FormicoRofo/1438-Puit-de-courant/3-Documents/1438-3501-00-Rapport_RD_pendant_le_TPI.docx

# Puit de courant

Table des matières

Versions

Version | Date | Auteur | Remarques
00 | 2024-04-24 | Alyx Vasseur | Version initiale

# 1 Cahier des charges

L’objectif de ce travail de TPI est de réaliser une carte de puit de courant réglable. Le design est tiré d’un article paru dans le magazine Elektor numéro 503 à la page 42. Pour plus de détail, consulter le cahier des charges numéro 1438.3001.00.

# 2 Planification

Liste des tâches | Durée
Routage et commande de PCB | 15H40
Fabrication et mise en service | 13H20
Documentation et administratif | 17H00
Total | 46H00

Planification complète : voir Planification numéro 1438.3600.00.

# 3 Analyse

## 3.1 Analyse de l'existant

Lors du pré-TPI, j’ai déjà analysé la réalisation de l’article d’Elektor et réalisé un schéma adapté dans Altium, et commandé les composants adaptés. Le détail de ce travail se trouve dans le document numéro 1438.3500.00.

## 3.2 Prise de décisions

J’ai choisi de partir sur une conception de PCB sur deux faces, avec des composants THT et SMD sur la face avant uniquement. Ainsi, la fabrication et le dépannage sont simplifiés et le stockage dans des racks est potentiellement plus simple. J’ai décidé d’organiser le PCB de la manière qui me semblait le plus ergonomique possible : Les connexions à l’alimentation et le fusible sur la gauche, et les réglages et points de connexion pour les instruments de mesure sur la droite. J’ai décidé de mettre des points de mesure à anneaux sur tous les points où une mesure au voltmètre serait envisageable, et des picots jumpers à tous les endroits où une mesure à l’oscilloscope pourrait être réalisée. J’ai également fait attention à ne placer aucun trimmer ou jumper immédiatement derrière un dissipateur thermique, ce qui rendrait moins pratique l’utilisation.

C’est une configuration qui favorise évidemment les utilisateurs droitiers, car il est plus compliqué de manipuler le bord droit de la carte de la main gauche. Cependant, une fois l’alimentation connectée, tourner la carte de 90° dans le sens horaire permet un accès totalement ambidextre aux réglages et points de mesure.

## 3.3 Problèmes rencontrés

### 3.3.1 Augmentation du courant à basse tension

Lors de la mise en service, j’ai remarqué que quand la tension d’alimentation est entre 3,1 et 3,6V, la linéarité du courant tiré n’est pas maintenue. Contre intuitivement ce denier augmente dans cette plage. Ceci se produit car la tension normalement régulée de -1,25V servant à commander le LM317 commence à se rapprocher de zéro. Cela a pour effet d’augmenter la tension de sortie du LM317, et donc l’appel de courant de tout le circuit. Pour résoudre ce problème, j’envisagerais deux solutions : remplacer le LM317 par un autre régulateur capable de sortir une tension de 0V sans autre circuit autour, ce qui permettrait de se passer complétement du bloc pompe de charge, ou remplacer le transistor K8 par un transistor au germanium et adapter les diodes R41 et R46. Ainsi la tension au point X17 sera plus haute de 0.4V lorsque l’alimentation sera dans le régime problématique grâce à sa tension UBE réduite. Cette mesure devrait à minima repousser la zone problématique à moins de 3,3V. Même si le problème persisterait probablement dans une moindre mesure entre 3,1 et 3,2V environ, le problème ne se situerait plus dans la zone opérationnelle de la carte.

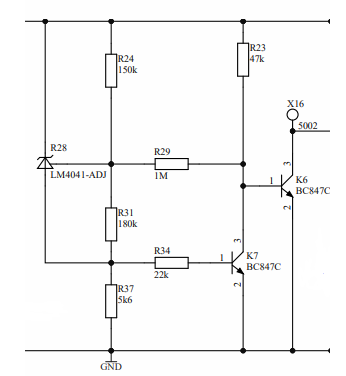
[picture p1: figure]

Après en avoir parlé à mon responsable de TPI, ses instructions sont de trouver un moyen d’augmenter la tension à partir de laquelle la protection contre les sous-tensions se déclenche. Ceci peut se faire sans trop de problème en changeant la résistance R24 par une valeur plus petite. Pour calculer cette valeur, il faut d’abord comprendre comment fonctionne cet arrêt.

Le régulateur shunt R28 laisse passer du courant de manière à toujours avoir 1,24V entre sa patte d’ajustement et sa patte positive. Ainsi, on peut facilement calculer le courant qui passe dans R24 (1,24/150000=8,266µA). Considérant R29 comme étant négligeable par rapport à R31 ou R24 on peut établir que la chute de tension sur R31 vaudra (180 * 8,266 *10⁻³ =1,488V). On peut donc déterminer que la chute de tension aux bornes de R28 sera de 2,72 V. Lorsque la tension d’alimentation passe en dessous de 3,2V, la chute de tension sur R37, qui correspond également à la tension UBE de K7 diminue à moins de 0,5V, ce qui déclenche la protection. Si on veut augmenter de 0,5V la tension à partir de laquelle la protection se déclenche, il suffit donc de diminuer R24 à la valeur qu’on peut trouver en résolvant l’équation suivante :

((1,24)/x)(x+180000)+0,5=3,7 1,24+180000*(1,24)/x=3,2 180000*(1,24)/x=1,96 (1,24*180000)/(1,96)=113877=x

En E12 on peut donc choisir une résistance de 100kΩ. Une fois ce changement fait, la tension de coupure se situe maintenant à 3,7V exactement comme désiré.

### 3.3.2 Dissipateur thermique pas assez efficace

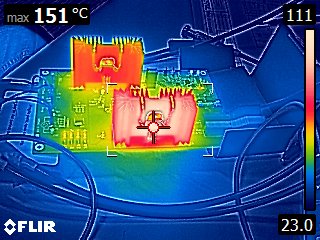
[picture p2: figure]

En utilisant une caméra thermique pour observer la carte, j’ai remarqué quelque-chose d’inquiétant. Alors que la puissance dissipée n’était que de 50% du maximum environ, le transistor K1 avait un point chaud mesuré à 151°C. La température maximale pour la jonction du BD912 est de 150°C. Après de rapides mesures pour s’assurer que le système fonctionnait correctement électroniquement, cela démontre un problème thermique évident. Ce résultat extrême peut potentiellement s’expliquer en partie par une émissivité mal réglée sur la caméra thermique. Cela dit, je suspecte principalement le fabriquant de survendre les capacités de son dissipateur. En effet la résistance thermique annoncée pour un dissipateur de cette taille est extrêmement basse. Il faut aussi noter que le fabriquant ne donne des valeurs que en comptant un flux d’air d’au minimum 1m/s (la valeur que j’ai prise pour mes dimensionnements). Même si c’est une vitesse faible, elle pourrait avoir un impact significatif également.

Cette surchauffe imprévue serait un élément de réponse pour expliquer pourquoi le premier BD912 a brûlé aussi rapidement quand poussé à son maximum.

Pour résoudre ce problème la première chose que je vais essayer est d’utiliser un refroidissement actif externe pour déterminer si c’est une solution suffisante, et le cas échéant il pourrait être implémenté directement dans la prochaine révision de la carte.

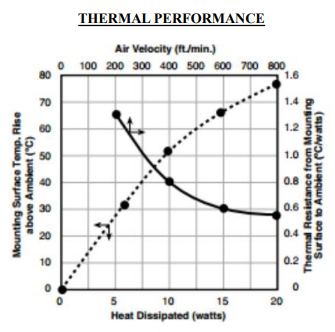
[picture p3: figure]

J’ai emprunté un ventilateur Noctua NF-A6x25 au bureau technique pour des tests thermiques. Cette marque est réputée pour des ventilateurs avec relativement peu de débit ou de pression statique, mais un bruit extrêmement bas. Selon les informations du fabriquant, il aurait un déplacement de 29.2m³/h. Considérant un canal de 60mm de diamètre (en réalité le moteur du ventilateur occupe une bonne partie de ce diamètre) cela résulterait à une vitesse de sortie minimale de 564.7pieds/s.

Sachant que le fabriquant de notre dissipateur annonce une résistance thermique qu’à partir de 200pieds/s (voir graphique ci-contre). C’est cette valeur que j’ai généralisée à une convexion naturelle. Je réalise maintenant que c’était probablement trop optimiste. Cela dit, un seul ventilateur tenu à la main sans guide pour le passage de l’air a suffi a mantenir le système dans des températures acceptables (en empiètant dans la marge de sécurité qui considérait la température ambiante à 40°C).

Extrait du datasheet du 678-39-C

Selon moi, la meilleure solution reviendrait à imprimer en 3d un adaptateur de montage pour un ventilateur sous le PCB, incluant des guides pour le flux d’air le contraignant à passer par les ouvertures sous les ailettes du dissipateur. Cependant, mon responsable de TPI préfère que je recherche un autre dissipateur plus efficace pour maintenir un fonctionnement sans ventilateur. Évidemment cette solution ne pourrait pas s’appliquer à l’unité produite durant mon TPI car cela impliquerait de refaire le PCB. Pour l’unité actuelle, mon supérieur technique m’a confié un petit ventilateur 12V. cependant en l’installant au dos du dissipateur, il ne suffit pas à éviter la surchauffe à puissance maximum.

Malheureusement, sur les sites des distributeurs usuels (Mouser, farnell etc..) je n’arrive pas à trouver meilleur refroidisseur. Le 678-39-C est systématiquement en tête de listes. Il semble en effet être un plutôt bon design pour un dissipateur de cette taille, mais il est également envisageable que le datasheet ne soit pas exact, ou représentatif de mesures en conditions idéales, ce qui n’est pas notre cas. Pour surclasser ses performances sans avoir recours à un dissipateur énorme et très onéreux, il faudrait probablement utiliser un dissipateur à ailettes pelées (skiving). Cela dit ces dissipateurs ont tendance à être chers, et à opposer une résistance importante au mouvement de l’air, ce qui oblige à utiliser un ventilateur optimisé pour la pression statique pour en tirer les meilleures performances. De plus, j’ai trouvé des plaques avec lesdites ailettes, mais aucun dissipateur prêt à l’emploi prévu pour un TO-220 avec cette technologie.

Finalement, mon responsable a trouvé un dissipateur qui pourrait potentiellement fonctionner : le 6400BG de Boyd Laconia. Il affiche une résistance thermique en convexion naturelle de 2,7°C/W sur sa page digikey, mais pas sur son datasheet. Il a été mis en commande, mais j’ai personellement peu d’espoir car ses performances annoncées en flux d’air sont nettement moins bonnes que celles annoncées pour le 678-39-C, mais seul l’expérimentation pourra tirer ça au clair.

# 4 Conception

## 4.1 Schémas

Tous les schémas ont été réalisés durant le pré-TPI. Voir document numéro 1438.3500.00 pour plus de détails.

## 4.2 Dimensionnement de composants

Les dimensionnements ont été réalisés durant le pré-TPI. Voir document numéro 1438.3500.00 pour plus de détails.

## 4.3 Design de PCB

Lors du design du PCB, j’ai dû porter mon attention sur plusieurs points. Premièrement, sachant que de forts courants allait passer dans les pistes, il fallait s’assurer que ces dernières aient une section suffisante pour ne pas trop s’échauffer. J’ai donc décidé de prendre un échauffement acceptable de 20K. Sachant que la carte est équipée d’un fusible de 2A, j’ai donc dimensionné la largeur des pistes à fort courant en prenant ces valeurs. En m’appuyant sur le guide de survie de M.Huser, j’ai pu déterminer qu’une largeur de piste de 0,75mm et une épaisseur de 35µm était suffisante. Pour éviter tout problème de dimensionnement de via, j’ai décidé de faire passer toutes les pistes à haut courant sur la face du dessus. Toutes les pistes à plus bas courant ont été faites avec une largeur de 0,25mm ce qui permet de facilement naviguer entre les pates des composants au format SOT-23 par exemple. Et dans le cas où un composant de faible courant venait à se mettre en court-circuit, le courant maximum de 2A défini par le fusible créerait un échauffement de moins de 100°C, qui ne devrait pas endommager le PCB.

La seule situation qui pourrait mener à un courant de plus de 2A sans que le fusible ne s’ouvre est dans le cas où un court-circuit est créé depuis un point de test avec un appareil connecté à la terre (s’il ne s’agit pas d’une source de tension flottante), ou à l’alimentation directement par exemple. Heureusement tous les points de mesure ont une impédance de sortie relativement élevée, et ne devrait pas poser de problème autre que l’invalidité de la mesure prise.

Les spécifications de la carte sont les suivantes :

Paramètre | Valeur | Unité
Dimensions (rectangle) | 160x100 | mm
Epaisseur totale | 1.6 | mm
Nombre de couches | 2 | -
Epaisseur cuivre fini | 35 | µm
Largeur minimale | 0.25 | mm
Isolation minimale | 0.15 | mm
Plus petit via (Øpastille / Øtrou / AR) [^1] | 1.25 / 0.711 / 0.2195 | mm / mm
Finition de surface | Sans plomb (HALS ou ENIG) | -
Vernis épargne brasure | Vert | -
Sérigraphie | Blanc | -
Pochoir | Non | -

Certaines pistes sur la face top doivent supporter jusqu’à 2A. Elles sont dimensionnées à 0,75mm de largeur.

PCB contrôlé avec le document 1438.5700.00. Résultat du contrôle : aucun problème.

# 5 Réalisation

## 5.1 Instructions de fabrication

### 5.1.1 Référentiel de production

Assemblage électronique : IPC-A-610, classe 1

### 5.1.2 Identification des dangers et mesures de protection/sécurité

Danger Mesures de protection

Décharges électrostatiques (ESD) : Port du bracelet, blouse

Dangers thermiques

Outillage chaud (fer à braser, four)

### 5.1.3 Qualification du personnel

- Niveau de formation : module FAB1
- Nombre de personnes : 1

### 5.1.4 Liste des équipements et outillages

- Fer à braser
- Four (à phase vapeur)
- Bruxelles ou machine d’aide au placement/à la pose de pâte
- Cadre de montage

### 5.1.5 Consommables

- Pâte à braser en seringue
- Fil de brasure

### 5.1.6 Instruction de travail

Durée : 4h20 + 3h de contrôle

1. Déposer de la pâte à braser sur tous les pads SMD à l’aide de d’une seringue.
2. Déposer les composants SMD aux divers endroits nécessaires.
3. Si vous avez choisi d’utiliser un LM2663 pour K9 (à la place d’un LM2662) il faut installer une résistance de 0Ω sur X9.
4. Ne pas installer C7. Les condensateurs électrolytiques de ce type supportent assez mal le passage au four.

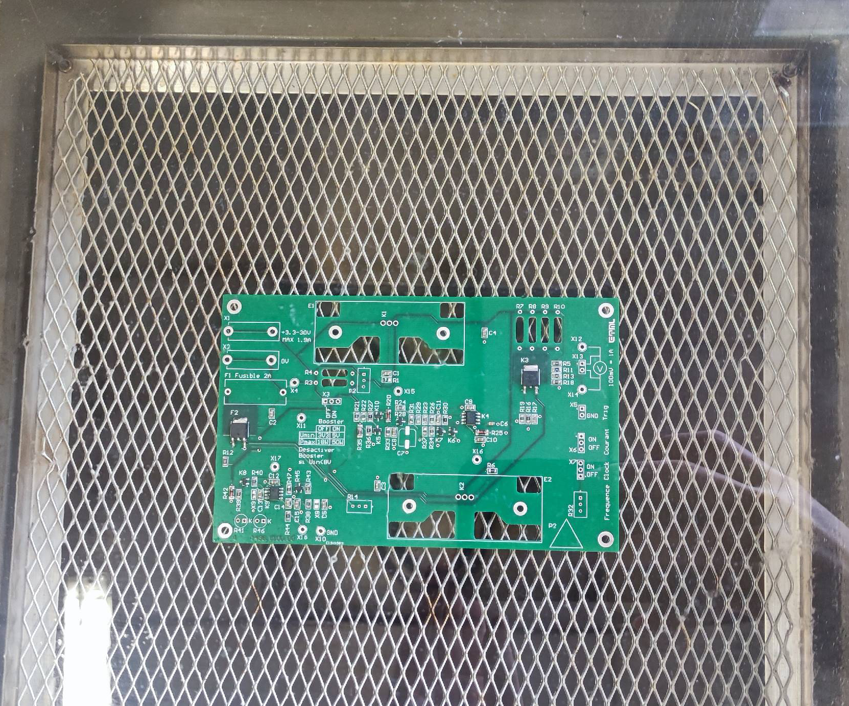
[picture p4: figure]

5. Passer la carte au four.
6. Vérifier et le cas échéant corriger les problèmes survenus au four (tombstone, patte mal brasée etc..). Ce sera plus compliqué quand les dissipateurs thermiques seront installés.
7. Installer les composants THT et C7. Les dissipateurs thermiques doivent être installés de telle manière à ce que leur côté avec beaucoup d’ailettes soit au-dessus des grandes ouvertures. N’oubliez pas de braser les pieds des dissipateurs, d’utiliser de la pâte thermo conductrice et d’installer le clip (ou la vis si vous utilisez la version à vis du dissipateur).
8. Coller le sticker P2. Il faut couper son coin pour que R32 ne gêne pas

### 5.1.7 Enregistrements qualité

Un autocontrôle a été réalisé et peut être consulté dans le document 1438.6600.00

### 5.1.8 Prochaine étape

Continuer avec le test de mise en service (point 6.1 de ce document).

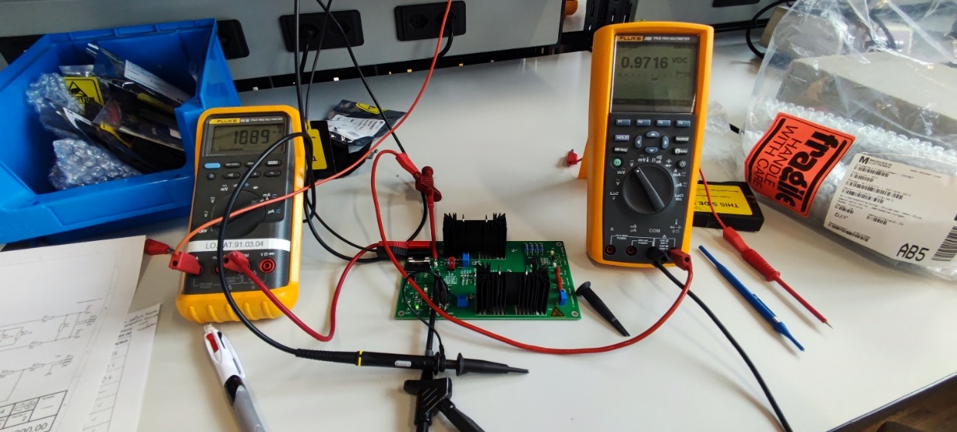
[picture p5: figure]

# 6 Tests

## 6.1 Mise en service

### 6.1.1 But

Tester le bon fonctionnement de la carte « Puit de courant » 1438.5100.00 et la calibrer.

### 6.1.2 Liste de matériel

Désignation | Marque | Type | Caractéristiques | No d'inventaire
G1 | Siglent | SPD3303X | Alimentation 0-32V 3.2A | Table 03 DAT
P1 | Fluke | 289 | Multimètre | LO.DAT.91.03.05
P2 | Fluke | 85 III | Multimètre | LO.DAT.91.03.04

### 6.1.3 Schéma électrique

Voir document 1438.5200.00.

### 6.1.4 Schéma de mesures

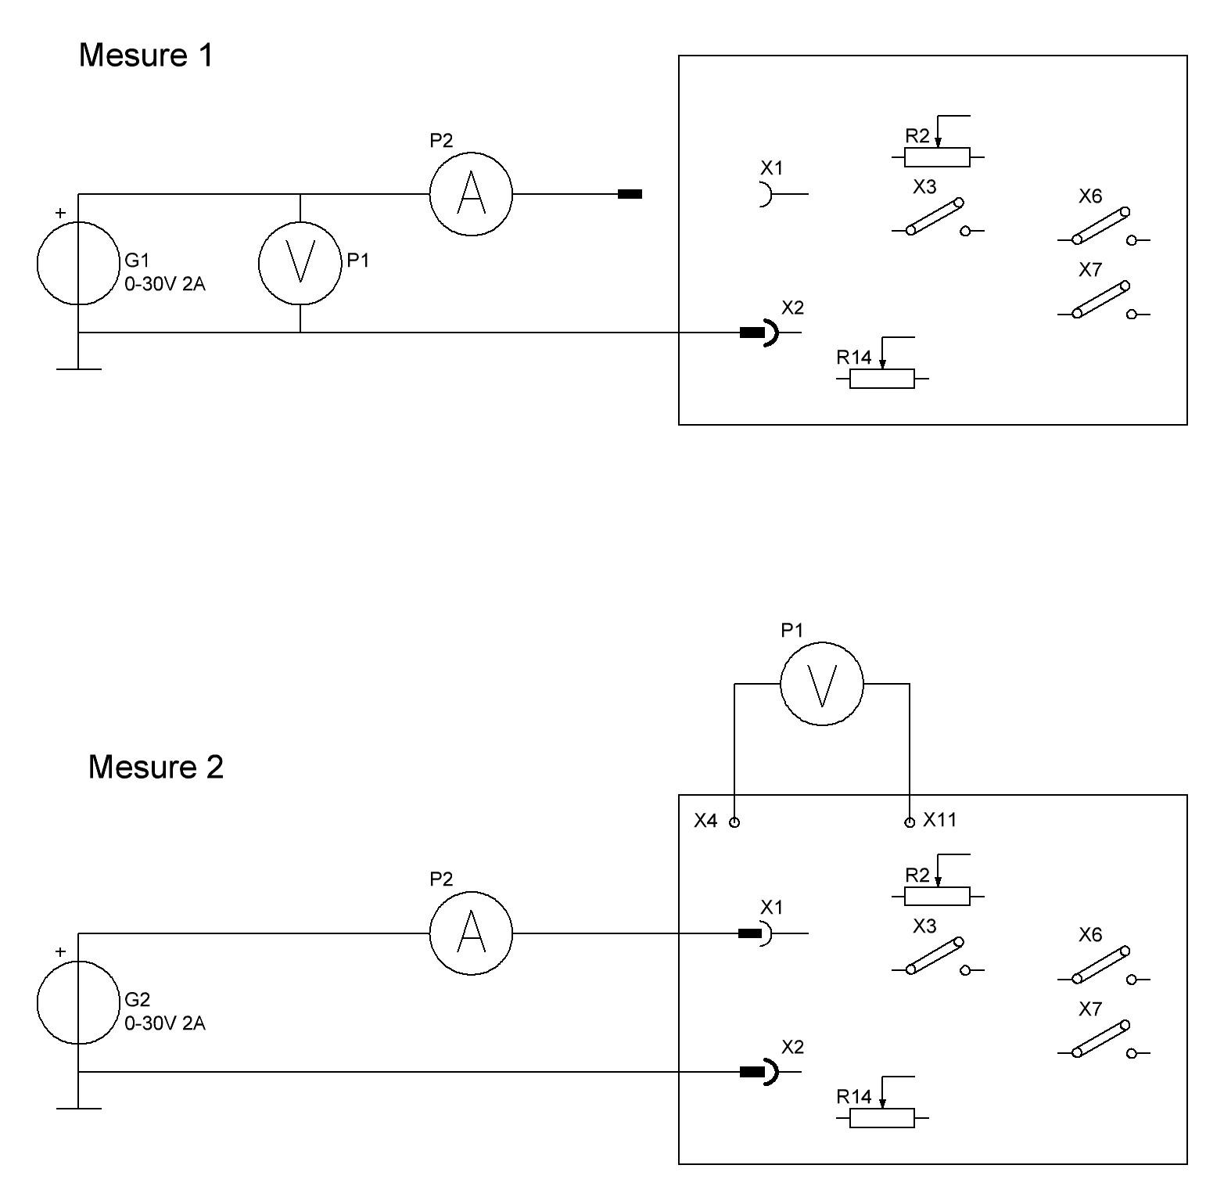
[picture p6: figure]

### 6.1.5 Conditions de mesures

Disposer les instruments de mesure comme dans le schéma « mesure 1 ». Placer un cavalier sur X6 en position « Courant ON » et un cavalier sur X7 en position « Clock OFF ».

### 6.1.6 Marche-à-suivre

| Instructions de mesure | Conditions de validation | Valeur mesurée | OK/KO
1.1 | Contrôler que X9 soit correct | Si K9 est un LM2662 : X9 non installé Si K9 est un LM2663 : X9 = 0Ω | LM2662 X9 non installé | OK
1.2 | Désactiver le booster en mettant un cavalier sur X3 (booster OFF) | | | OK
1.3 | Régler G1 sur 3V et limitation de courant à 100mA puis brancher X1 Régler le courant au minimum avec R14 | | | OK
1.4 | Mesurer le courant | Courant absorbé = 10±5mA | 14,06mA | OK
1.5 | Augmenter la tension[^2] à 3,7V, ajuster R14 pour obtenir un courant de 80±5 mA | | 80,0mA | OK
1.6 | Réduire la tension à 3,05±0,05V | Courant =10±5mA | 14,05mA | OK
1.7 | Augmenter la tension à 5V et régler le courant au minimum avec R14 | Courant < 30mA | 21,71mA | OK
1.8 | Si le point 1.7 n’est pas vérifié, installer une résistance de 0Ω sur X8 et réessayer | | - | -
1.9 | Tourner R2 dans le sens antihoraire au maximum | | | OK
1.10 | Mettre X3 sur « booster ON » | | | OK
1.11 | Augmenter la tension de G1 à 15V et la limite de courant à 1,1A. Utiliser R14 pour régler le courant consommé à 1A, connecter P1 comme sur le schéma de mesure numéro 2 | | | OK
1.12 | Régler R2 de manière à ce que la tension entre X4 et X11 vaille 1V | X4-X11=1±0.05V | 0.991V | OK
1.13 | Augmenter la tension à 25V et le courant à 1.9A. Laisser la carte chauffer quelques minutes. | X4-X11=1±0.05V | 0.984V | OK
1.14 | Au besoin, ajuster R2 pour que X4-X11 = 1±0.05V lorsque l’alimentation est à 25V 1,9A | | 0.972V | OK

### 6.1.7 Résultats

La carte est en état de fonctionnement. Il faut noter que lorsque l’alimentation est entre 3,1 et 3,6V, la protection s’active et se désactive à répétition à cause d’une chute de tension due à l’appel de courant lors de l’activation. Cette chute est due à la limitation de courant de l’alimentation. Celle-ci est déclenchée car la tension normalement régulée de -1,25V commence à se rapprocher de zéro lorsque la tension d’alimentation. Voir le point 3.3.1 de ce document.

J’ai également appris à mes dépends (un BD910 a brulé) qu’il est impératif de respecter les 50W maximum de dissipation. Même si la tension maximale d’entrée est de 30V et le courant maximal est de 1,9A, ces deux valeurs ne peuvent pas être atteintes en même temps. Par sécurité il peut être sage de régler le booster pour tirer un peu moins de courant car le LM317 est équipé d’une protection thermique intégrée, ce qui n’est pas le cas du booster. Voir le point 3.3.2 de ce document.

### 6.1.8 Décision

Malgré les problèmes observés, la carte est sûre pour continuer les tests plus poussés.

## 6.2 Rapport de test

### 6.2.1 But

Tester les différentes fonctionnalités de la carte « Puit de courant » numéro 1438.5100.00.

### 6.2.2 Schéma de mesure

Booster ON pour toutes les mesures

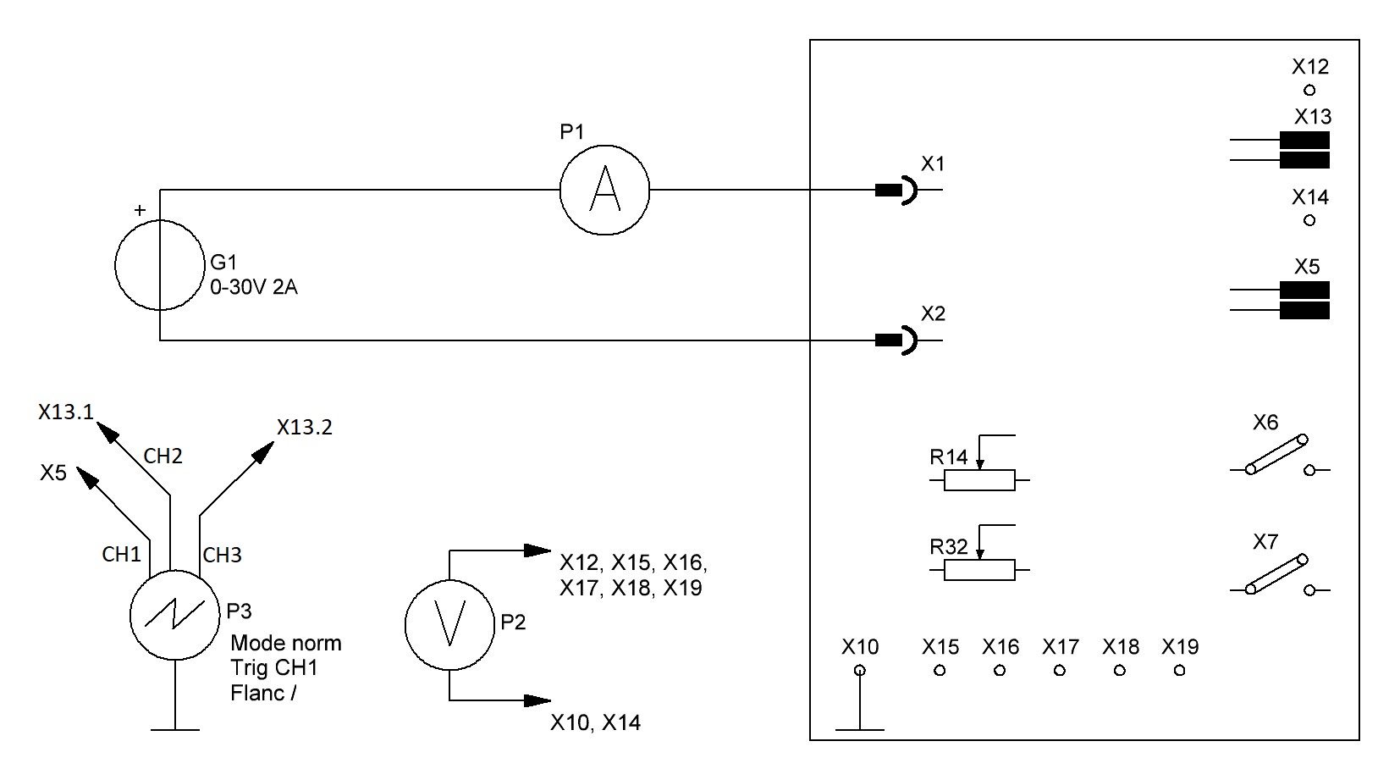
[picture p7: figure]

### 6.2.3 Liste de matériel

Désignation | Marque | Type | Caractéristiques | No d'inventaire
G1 | Siglent | SPD3303X | Alimentation 0-32V 3.2A | Table 03 DAT
P1 | Fluke | 85 III | Multimètre | LO.DAT.91.03.04
P2 | Fluke | 289 | Multimètre | LO.DAT.91.03.05
P3 | Keysight | DSOX1204G | 100MHz 2GSa/s | LO.DAT.91.03.06

### 6.2.4 Tableau de mesure

Mesure | Condition de mesure | Valeur mesurée | Valeur attendue | Erreur absolue | Erreur relative
X12-X14 (P2) | Courant ON, Clock OFF Uin= 15V I= 500mA | 48,21mV | 50±5mV | 1,79mV | 3,58%
X12-X14 (P2) | Courant ON Clock OFF Uin= 15V I= 1A | 98,52mV | 100±5mV | 1,48mV | 1,48%
X12-X14 (P2) | Courant ON Clock OFF Uin= 15V I= 1,5A | 149,4mV | 150±5mV | 0,6mV | 0,4%
X15-X10 (P2) | Courant ON, Clock OFF Uin= 15V I= 500mA | 6,474V | 6,5±0,5V | 0,026V | 0.4%
X16-X10 (P2) | Courant ON, Clock OFF Uin= 15V I= 500mA | 6,377V | 6,5±0,5V | 0,123V | 1,9%
X16-X10 (P2) | Courant ON, Clock OFF Uin= 3V I= 500mA | 6,7mV | 0±100mV (I tombe à 10mA) | 6,7mV
X17-X10 (P2) | Courant ON Clock OFF Uin= 15V I= 500mA | 3,2442V | 3.3±0,3V | 0,0558V | 1,6%
X18-X19 (P2) | Courant ON Clock OFF Uin= 15V I= 500mA | -1,2531V | -1,25V±0,3V | 0,0031V | 0,248%
X5.1 X13.1-X13.2 (P3) | Courant ON Clock ON Uin =15V I=500mA Mode math CH2-CH3 | Signal Carré Fmin : 29,54Hz Fmax : 6,47KHz | Signal carré en phase, Plage de fréquence minimale en ajustant R32 : 36Hz-1,7kHz
Test protection inversion de polarité | Uin=-15V Courant ON, Clock OFF I=500mA | I=0mA | I = 0mA, fusible ne fonds pas.

### 6.2.5 Conclusion

À l’exception du problème en basse tension lors de la mise en service, la carte fonctionne parfaitement. Les réglages se font sans soucis, et la mesure est facile et plutôt précise.

## 6.3 Évaluation du projet

Le projet avance bien. L’unité montée fonctionne dans une grande gamme de situations. Pour la suite du projet plusieurs solutions se présentent et promettent des développements intéressants.

## 6.4 État d'avancement du projet

Une unité fonctionnelle a été montée. Malgré des erreurs de design mineures (le mauvais fonctionnement entre 3 et 3,6V, la position et la sérigraphie de R14) qui pourrait être améliorées, le projet est globalement terminé.

## 6.5 Travaux restants à effectuer

Actuellement, nous disposons de tout le matériel pour monter le deuxième PCB comme une copie identique du premier, potentiellement en remplaçant K8 par un transistor au germanium pour permettre le fonctionnement entre 3,3 et 3,6V.

Pour le reste des composants destinées à la fabrication d’autres unités, deux options sont à envisager :

1. Corriger les petits défauts de sérigraphie et essayer de mitiger voire éliminer le problème à basse tension par divers moyens. Cela a l’avantage d’utiliser en grande partie des composants déjà achetés.
2. Revoir le design à un niveau plus fondamental en remplaçant le LM317 par un régulateur capable de descendre à 0V de sortie. Ainsi on supprime tout le bloc de pompe de charge, ce qui diminuerait par conséquent les coûts et la complexité, mais demanderait de ne plus utiliser les LM317 déjà achetés. Cela dit un LM317 est un composant fréquemment utilisé, qui sera probablement utilisé lors d’autres projets.

## 6.6 Améliorations

Le projet présente quelques défauts et limitations qu’il pourrait être bon d’améliorer :

1. Remplacer le LM317 par un régulateur capable de descendre à 0V et supprimer le bloc pompe de charge
2. Potentiellement déplacer R14, et ajouter une description de l’effet de R14 et R2 sur la sérigraphie
3. Ajouter des flèches qui indique le sens de réglage des potentiomètres.
4. Mettre le mosfet coupe circuit (et le remplacer par un canal P), le mosfet de protection et le fusible en amont du réseau de résistance qui sert de point de mesure du courant pour permettre une mesure du courant avec une seule sonde en référence à la masse.
5. Remplacer la sérigraphie du sticker P2 par un triangle ou carré plein pour un meilleur contraste sur le sticker.
6. Intégrer un système de protection pour éviter la surchauffe du K1.
7. Trouver une solution au problème thermique du booster, que ce soit un autre dissipateur, un ventilateur ou autres.
8. Investiguer et résoudre le problème qui empêche le bon fonctionnement en dessous de 3,7V.

# 7 Conclusion

Au-delà de petits soucis d’ergonomie, du problème de surchauffe et de problèmes de conception remontant à plusieurs années (le choix d’utiliser un LM317 avec une pompe de charge, plutôt qu’un régulateur plus adapté a été fait par l’auteur de l’article Elektor plusieurs années avant la parution de l’article, simplement sur la base des composants en stock dans son atelier), le projet est pour moi un franc succès. C’est déjà incroyable d’avoir réussi à mener ce projet et sans aucune embûche majeure, obtenir un appareil fonctionnel et utile.

# Annexe A Planification

## A.1 Journal de travail

## A.2 Planification et suivi

# Annexe B Documents de production

## Annexe C Schémas

## Annexe D Plan d'implantation

## Annexe E Maquette PCB

## Annexe F Liste de pièces

# Annexe G Autres documents

## Annexe H Rapport R&D pré-TPI

## Annexe I Autocontrôle de la qualité de l’assemblage

## Annexe J Autocontrôle du routage du PCB

[^1] AR=0.5∙(∅_(pastille) -∅_(trou_final) -0.1) [mm] Anneau résiduel
[^2] La valeur de test était initialement de 3,3V et a été augmentée durant la procédure en raison du problème relevé ci-dessous (voir points 6.1.7 et 3.3.1).

Page 3 sur 16

Auteur : AV Modifié par : Dernière modification le 24/04/2024 10:15 Page 1 sur 16 Créé le 26/09/2023 Imprimé le 24/04/2024 10:27 1438-3501-00-Rapport_RD_pendant_le_TPI.docx

ETML Section électronique Alyx Vasseur –Rapport R&D – 1438.3501.00

ETML Section électronique Alyx Vasseur – Rapport R&D – 1438.3501.00
