FormicoRofo/1438-Puit-de-courant/3-Documents/1438-3500-00-PreTPI.docx

# PréTPI Puit de courant

Table des matières

Versions

Version | Date | Auteur | Remarques
00 | 2024-03-11 | AVR | Version initiale

# 1 Cahier des charges

Le but de ce rapport est de remplir les tâches attribuées au pré-TPI dans le cahier des charges de ce dernier. À savoir :

- Dessiner le schéma sur Altium en utilisant la nomenclature CEI
- Ajouter des points de tests aux endroits stratégiques
- Remplacer R20 par un potentiomètre et une résistance en série pour pouvoir régler la fréquence de commutation de charge entre 40Hz et 1.2kHz
- Intégrer sur le schéma le booster et des bornes bananes 5mm
- Dimensionner des radiateurs pour le LM317 et le transistor du booster
- Etablir une liste de pièce
- Commander les composants

# 2 Planification

Liste des tâches | Durée
Copier et adapter le schéma | 15h00
Etablir une liste de pièces | 15h00
Commander les composants | 10h00
Documentation | 10h00
Total planifié | 50h00
Total réalisé | 49h20
Différence | 1,32%

# 3 Analyse

## 3.1 Analyse de l'existant

J’ai à disposition le schéma du magazine Elektor, ainsi que les plans d’un PCB réalisés par leurs soins. Les schémas téléchargeables et ceux dans l’article ne sont pas identiques, il faudrait donc trancher entre les deux quelle valeur suivre pour notre choix de composants. Il nous faut également choisir des dissipateurs thermiques appropriés, tout en faisant attention à leur méthode de montage.

### 3.1.1 Choix des dissipateurs thermiques

Nous n’avons pas vraiment de raison d’utiliser des IC différents de l’article Elektor pour la dissipation de la puissance. Nous allons donc baser nos calculs sur les datasheets du LM317 et du BD210/212, tous deux dans un package TO-220. En regardant dans leur datasheet, on peut trouver leur température maximale à la jonction et la résistance thermique entre cette dernière et la surface du boitier. Par convention on détermine une température ambiante de 40°C. On peut donc réaliser le circuit thermique suivant :

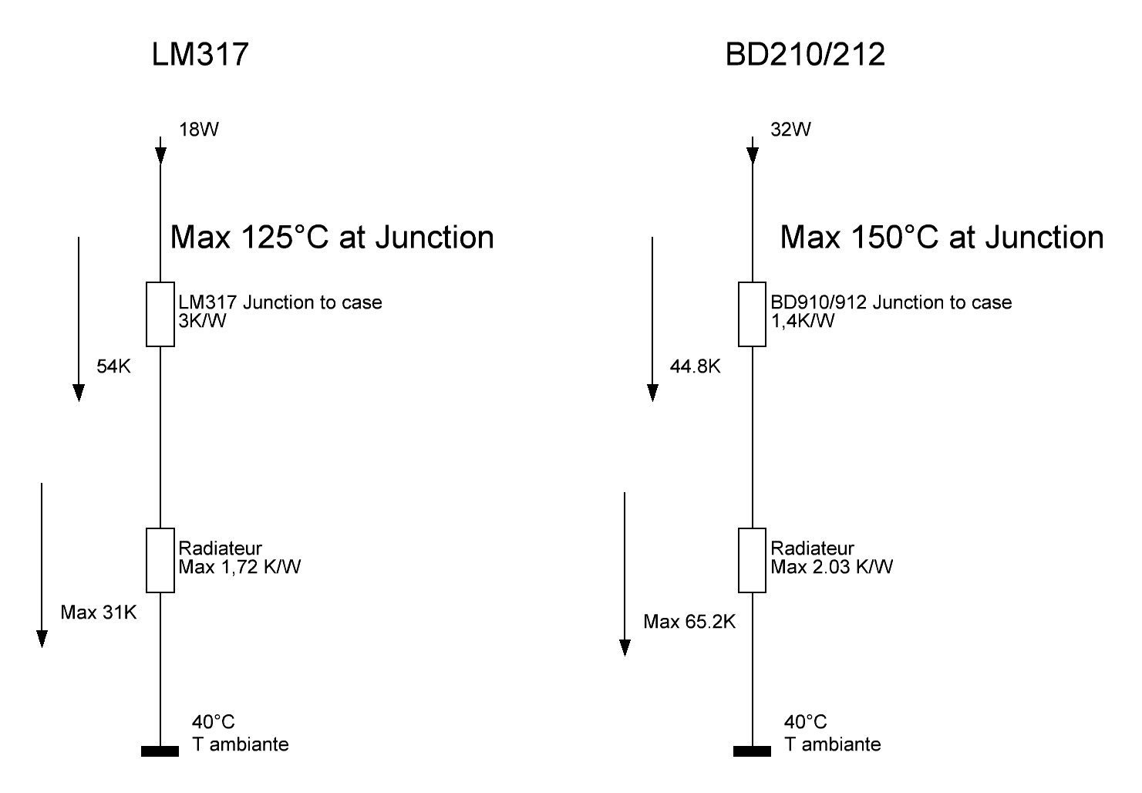
[picture p8: figure]

Ces résultats sont encore plus exigeants que les consignes données dans l’article. Ce dernier recommande des dissipateurs de moins de 2K/W. Une résistance thermique de 1,7K/W est très faible, et difficile à atteindre sans un refroidissement actif (un ventilateur ou un refroidissement hydraulique par exemple). Par chance, nous avons réussi à trouver un dissipateur qui pourrait fonctionner. Le 678-39-C de Wakefield Thermal est un dissipateur thermique en alliage d’aluminium. Il est adapté à une large gamme de boitiers dont les TO-220. Malgré sa taille modeste de 25mm par 60mm et 40mm de haut, son grand nombre d’ailettes lui confère une résistance thermique d’environ 1,3K/W dans un flux d’air de 1m/s (ou environ 3,6km/h) ce qui correspond à une brise très légère. Il se monte au PCB grâce à des pieds étamés, et se fixe au composant par un clip (il existe une variante à vis, le 678-39-S un peu moins cher mais actuellement en rupture de stock). À un prix d’un peu moins de 5CHF par unité, c’est le meilleur compromis que nous avons pu trouver pour ce projet.

### 3.1.2 Choix de la taille des composants

Étant donné que le produit n’est pas destiné à être réalisé en plus de 10 exemplaires, il sera entièrement produit à la main et pas de pochoir sera utilisé. Certains composants de puissance et connecteurs seront forcément traversant, cependant dans le but d’optimiser l’espace utilisé (déjà que celui-ci sera occupé en partie par deux grands dissipateurs thermique) il semble avisé d’opter pour des composants montés en surface lorsque possible. Cela pose en revanche une question de puissance admissible par les résistances. Vu que la carte sera assemblée à la main, utiliser des résistances SMD de grande taille me parait plus facile. Dans la mesure du possible, on va donc se limiter au résistances de taille 1206 (321,6 métrique) et 0805(2012 métrique). Ces dernières ont une puissance maximale de 0,25 W et 0,125 W respectivement. Sachant les formules suivantes :

P=(U^2)/R⟺R=(U^2)/P

Sachant que la tension opérationnelle de notre système est de 30V, on peut donc calculer pour des puissances de 0,25 et 0,125W les valeurs de résistances au-delà de laquelle on sait qu’elle ne dépassera jamais sa puissance maximale lors d’une utilisation standard.

(30^2)/(0,25)=3600Ω (30^2)/0125=7200Ω

Pour les résistances en dessous de ces valeurs il faudra procéder à un dimensionnement complet.

### 3.1.3 Choix du potentiomètre du TLC555

Le schéma d’Elektor viens avec une résistance simple de 150K et d’un condensateur de 100nF. Le schéma n’utilise pas la patte décharge du 555 mais sa sortie, pour avoir un largeur d’impulsion de 50% sans court-circuiter l’alimentation. En utilisant la formule du 555 suivante, on peut calculer la fréquence sélectionnée par les composants choisis.

frequency ≈(1,44)/(2*R*C)

Dans ce cas on aurait donc une fréquence 48Hz. C’est une fréquence pratique pour analyser la qualité d’une alimentation, car la charge sera active pendant environ une demi-période du réseau, et du au petit décalage la synchronisation entre la charge et le réseau vont petit à petit se décaler, ce qui permet d’observer le comportement de l’alimentation en fonction du décalage de phase de la charge.

Dans notre cas, il est demandé d’adapter ce système pour pouvoir être ajusté dans une plage de 40Hz à 1.2kHz. J’ai donc choisi d’utiliser un potentiomètre en série avec une résistance (pour éviter que quand le potentiomètre approche son minimum, la fréquence tende hyperboliquement vers l’infini car le terme au dénominateur s’approcherait de zéro.

Cependant, il faut aussi faire attention aux tolérances du condensateur, du potentiomètre et de la résistance. Il faut aussi prendre en compte que le curseur du potentiomètre ne peut pas non plus parcourir 100% de la bande résistive qui le compose, et qu’il faut donc considérer que le potentiomètre ne peut varier qu’entre 1% et 99% de sa valeur.

En utilisant un tableur, j’ai pu facilement calculer en direct les fréquences garanties en fonction de ces divers facteurs.

Condensateur | 1.00E-07 | Tolérance | 10%
Potentiomètre | 250000 | Tolérance | 10%
Résistance | 1000 | Tolérance | 1%
Pire des cas Basse fréquence
Condensateur | 9.00E-08
Potentiomètre | 225000.00
Curseur Potentiomètre (99%) | 222750.00
Résistance | 990.00
Fréquence | 35.755788
Pire des cas Haute fréquence
Condensateur | 1.10E-07
Potentiomètre | 275000.00
Curseur Potentiomètre (1%) | 2750.00
Résistance | 1010.00
Fréquence | 1740.81238

Mon choix s’est finalement porté sur ces valeurs. Elles correspondent à celles d’un potentiomètre de la marque Bourns. La valeur de la résistance et du condensateur ont été choisie car elles apparaissent déjà ailleurs dans l’appareil, ce qui limitera le nombre d’entrées différentes dans la liste de pièces.

# 4 Conception

## 4.1 Schémas

Le dessin des schémas s’est fait avec Altium Designer. J’ai suivi à la lettre le schéma de l’article, car la version téléchargeable est plus vieille de plusieurs années, et la version présentée a été réalisée par l’auteur, ce qui nous montre donc qu’elle fonctionne. Sur le blog d’Elektor l’auteur confirme également que la version publiée dans l’article est la version finale.

Dans ce même blog un internaute suggère d’ailleurs une modification du schéma : utiliser un régulateur de tension capable de d’ajuster sa tension de sortie jusqu’à 0V comme le LT3080 par exemple. Ceci permettrait de s’exempter de tout le bloc pompe de charge qui sert normalement à donner une tension de référence négative au LM317 pour lui permettre d’atteindre 0V. L’auteur a répondu à son commentaire que l’idée était excellente, mais qu’il a utilisé un LM317 car il en avait sous la main et que à la base le projet était destiné à tester des chargeurs USB (5V 2A) ce que le LM317 fait très bien, mais quand il a repris le design pour améliorer les capacités de l’appareil, il a voulu conserver un maximum du design du pcb existant et a donc conservé le LM317.

Il aurait probablement été mieux d’utiliser un LT3080, malheureusement j’ai pris conscience de cette possibilité trop tard dans le développement du schéma, et il aurait probablement fallu modifier le cahier des charges pour intégrer cette modification.

Le dessin du schéma lui-même s’est bien passé. J’ai trouvé un moyen de modifier et d’utiliser des symboles de composants téléchargés depuis l’onglet « manufacturer part search » qui fournit des pack de composants pouvant inclure symbole, footprint, profil de simulation etc.. Le dessin a été grandement accéléré de cette manière, et de multiples footprints ont été automatiquement importés également.

Pour le placement des points de test, j’ai choisi de mettre des bornes à œillets à toutes les tensions d’alimentations, points de mesure pour un réglage lors de la mise en service, et point où une mesure au multimètre serait cohérente dans son utilisation quotidienne. Pour les points où l’oscilloscope serait utilisé, j’ai placé des paires de picots jumper 2,54mm pour une utilisation facile et peu encombrée avec les cables BNC vers jumper.

## 4.2 Dimensionnement de composants

Sur le schéma de l’article, tous les composants de puissance ont une puissance indiquée. Pour les autres composants, on peut dans un premier temps se fier au calcul ci-dessus pour s’assurer que toutes les résistances élevées n’ont pas de soucis à se faire. Pour tous les composants restants, calculer leur tension maximale ou puissance maximale est trivial, et ne sera pas détaillé ici. On trouve que les résistances de 1/8W sont suffisantes et que les condensateurs 1uF 25V sont suffisants à tous les endroits où ils sont utilisés.

## 4.3 État d'avancement du projet

Le schéma et la liste de pièces sont terminées. Une grande partie des empreintes de composants sont prêtes. Il faudra encore les vérifier, mais le projet est en bonne voie.

## 4.4 Travaux restants à effectuer

- Dessiner les footprints manquants
- Contrôler tous les footprints
- Router le PCB
- Commander le PCB
- Assembler le PCBA
- Etablir un protocole de mise en service
- Produire un manuel d’utilisation
- Décider d’une solution mécanique (pieds, plaque de plexiglass) et adapter la documentation
- Mettre en service l’unité produite

## 4.5 Améliorations

Une amélioration qui aurait pu être faite est de prendre un LT3080 ou équivalent pour pouvoir se passer de tout le bloc pompe de charge et simplifier la conception.

# 5 Conclusion

Le projet avance bien, et est dans un état qui permet de commencer le TPI sans problème.

Page 4 sur 6

Auteur : AV Modifié par : Dernière modification le 21/03/2024 08:52 Page 1 sur 6 Créé le 26/09/2023 Imprimé le 24/04/2024 10:48 1438-3500-00-PreTPI.docx

ETML Section électronique Nom -Type - Numéro

ETML Section électronique Alyx Vasseur – Rapport R&D – 1438.3500.00
