FormicoRofo/1438-Puit-de-courant/3-Documents/1438-3001-00-Cahier_des_charges_pendant_le_TPI.docx

# Puit de courant pendant TPI

Accroche.

Version | Date | Auteur | Remarques
00 | AAAA-MM-JJ | PMT | Version initiale

# 1 Description Générale du projet

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

# 2 Travail à faire

Router un PCB au format simple EU si possible. Nous désirons une sérigraphie indiquant la nomenclature des composants qui soit lisible après montage de ces derniers, ainsi que des indications en texte pour les réglages, jumper et points servant à la synchro de l’oscilloscope. Prévoir les TP sous forme de pastilles dans lesquelles on pourra souder un picot si cela s’avère utile lors de la mise au point. Prévoir des bornes bananes 5mm pour les alimentations sur le bord du PCB, idem pour les jumpers et l’accès au signal de synchro de l’oscilloscope en bord de PCB. Prévoir 4 trous sur les bords, avec pastilles qui pourront accueillir des colonnettes M3 qui serviront de pied ou d’interface avec une plaque d’isolation en polycarbonate. Commander 2pces du PCB le mercredi avant les vacances de Pâques. Après les vacances de Pâques, monter les composants sur 1 PCB et conserver 1 PCB non monté. Effectuer une mise en service et tester les différentes fonctions. Rendre un rapport de mise en service et de mesures, une feuille d’autocontrôle de la fabrication et un rapport concluant sur le routage du PCB.

# 3 Plan d’action

1. S’informer sur le projet
2. Planifier et décomposer le projet en tâches en utilisant le document ad-hoc
3. Décider et décrire les solutions retenues dans le rapport R&D
4. Réaliser
5. Contrôler et consigner les résultats
6. Évaluer le projet et formuler des constats et des pistes d’améliorations

# 4 Délais

- 24.04.2024

# 5 Particularités

Lausanne, le 01.03.2024

Le supérieur technique : Patrick Millet Le responsable du travail :

Page 2 sur 2

Créé le 26/09/2023 Dernière modification le 06/03/2024 10:40 Page 1 sur 1 Imprimé le 27/05/2010 10:26 Document2

ETML Section électronique Nom - Type - Numéro

ETML Section électronique Puit de courant - ECOLE - 1438
