FormicoRofo/1438-Puit-de-courant/3-Documents/1438-3300-00-PreTPI.docx

TITRE

But

Texte

Table des matières

Schéma électrique

Texte

# Analyse théorique

Texte

# Liste de matériel

Désignation | Marque | Type | Caractéristiques | No d'inventaire

# Schéma de mesures

Texte

# Tableau de résultats

Texte

# Analyse des résultats

Texte

# Conclusion

Texte

# Annexe

- Courbe
- Chronogramme
- Oscillogramme

ETML, le

Nom Prénom

Signature

Auteur : Matthias Huser Modifié par : Dernière modification le 00/00/0000 00:00 Page 2 sur 2 Créé le 26/09/2023 Imprimé le 21/05/2010 09:26 Document2

Auteur : MH Modifié par : Dernière modification le 00/00/0000 00:00 Page 1 sur 2 Créé le 26/09/2023 Imprimé le 21/05/2010 09:26 Document2

ETML Section électronique Nom -Type - Numéro

ETML Section électronique Secteur - Nom - Type - Numéro
