FormicoRofo/1438-Puit-de-courant/5-Hardware/1438-5100-00-Puit de courant/1438-5600-00-Puit de courant_BOM.xlsx

 | Titre | Puit de courant |  | Numéro | 1438.5600.00 |  | ETML
 | Devise | CHF |  | Dessiné | AVR | 2024-03-08
 | Qté production | 1 |  | Controlé | - | -
Pos. | Designator | Description | PN | Quantity | Supplier 1 | Supplier Part Number 1 | Supplier Price 1 | Order Qty | Total | IsStocked
1 | 1 | PCB element for BOM | 1438.5100.00 | 1 | Eurocircuits Sàrl | E1595562 | 52.0500 | 1 | 52.0500 | FALSE
2 | C1, C2, C3, C4, C9, C11 | CAPC 100nF X7R 50V 10% 2012 (0805 INCH) | KAM21AR81H104KU | 6 | Mouser | 581-KAM21AR81H104KU | 0.2590 | 6 | 1.5540 | 1
3 | C5, C8, C10, C12, C13, C14, C15 | CAPC 1uF X5R 25V 10% 2012 (0805 INCH) | KGM21AR51E105KU | 7 | Mouser | 581-KGM21AR51E105KU | 1.0000 | 7 | 7.0000 | 1
4 | C6 | CAPC 10nF X7R 50V 10% 1608 (0603 INCH) | PN-514948 | 1 | ETML | FAB.0603_C 10nF | 0.0123 | 1 | 0.0123 | 1
5 | C7 | Aluminum Electrolytic Capacitor, UD Series, Low Impedance, 220 uF, 16 V, + / - 20%, -55 to 105 degC, Chip Type, 6.3 x 7.7 mm D x L, Pb-Free, Reel |  | 1 |  |  |  | 1 | 0.0000
6 | E1, E2 | HEAT SINK, ALUMINIUM, TO-PACKAGE, SMD |  | 2 |  |  |  | 2 | 0.0000
7 | F1 | Fusible FST 2A temporisé | 261.476 | 1 | ETML | MAG 261.476 | 0.3300 | 1 | 0.3300 | TRUE
8 | F2, K3 | N channel Mosfet |  | 2 |  |  |  | 2 | 0.0000
9 | K1 | PNP transistor |  | 1 |  |  |  | 1 | 0.0000
10 | K2 | TO-220 ajustable votage regulator |  | 1 |  |  |  | 1 | 0.0000
11 | K4 | IC OSC SGL TIMER 2.1MHZ 8-SOIC | TLC555CDR | 1 | Mouser | 595-TLC555CDR | 0.5530 | 1 | 0.5530 | 1
12 | K5, K6, K7, K8 | NPN general purpose transistor |  | 4 |  |  |  | 4 | 0.0000
13 | K9 | Switched Capacitor Voltage Converter, 8-pin Narrow SOIC | LM2662M | 1 | Farnell | 9306803 | 2.5100 | 1 | 2.5100 | 1
14 | K10 | General Purpose Transistor, PNP Silicon, 3-Pin SOT-23, Pb-Free, Tape and Reel |  | 1 |  |  |  | 1 | 0.0000
15 | P2 | PIC W017-TRI 015-PE-SHEET/1 | PIC W017-TRI 015-PE-SHEET/1 | 1 | Distrelec | 302-20-433 | 0.2460 | 1 | 0.2460 | 1
16 | R1 | RES 150ohm ±1% 0.125W 2012 (0805 INCH) | PN-455993 | 1 | ETML | FAB.0805_R 150R | 0.0200 | 1 | 0.0200 | 1
17 | R2, R14 | RESADJ 200ohm Cermet 25 turns | PN-614445 | 2 | Farnell | 9353747 | 3.3600 | 2 | 6.7200 | 1
18 | R3, R4 | Résistance traversante, 3.3 ohm, ROX, 1 W, ± 5%, Axial, 350 V | PN-918915 | 2 | Farnell | 3399704 | 0.1500 | 2 | 0.3000 | 1
19 | R5, R13, R34 | RES 22kohm ±1% 0.125W 2012 (0805 INCH) | PN-851075 | 3 | ETML | FAB.0805_R 22k | 0.0200 | 3 | 0.0600 | 1
20 | R6, R18 | RES 220ohm ±1% 0.125W 2012 (0805 INCH) | PN-694076 | 2 | ETML | FAB.0805_R 220R | 0.0200 | 2 | 0.0400 | 1
21 | R7, R8, R9, R10 | Résistance traversante, 2.2 ohm, ROX, 1 W, ± 5%, Axial, 350 V | PN-918915 | 4 | Farnell | 3399704 | 0.1500 | 4 | 0.6000 | 1
22 | R11, R12, R21, R36 | RES 10kohm ±1% 0.125W 2012 (0805 INCH) | PN-374909 | 4 | ETML | FAB.0805_R 10k | 0.0200 | 4 | 0.0800 | 1
23 | R16 | RES 1.8kohm ±1% 0.125W 2012 (0805 INCH) | PN-653534 | 1 | ETML | FAB.0805_R 1K8 | 0.0200 | 1 | 0.0200 | 1
24 | R17, R23 | RES 47kohm ±1% 0.125W 2012 (0805 INCH) | PN-427242 | 2 | ETML | FAB.0805_R 47k | 0.0200 | 2 | 0.0400 | 1
25 | R19, R22 | RES 220kohm ±1% 0.125W 2012 (0805 INCH) | PN-479575 | 2 | ETML | FAB.0805_R 220k | 0.0200 | 2 | 0.0400 | 1
26 | R20, R25, R42 | DIODE GEN PURP 75V 150MA SOD80 |  | 3 |  |  |  | 3 | 0.0000
27 | R24 | RES 100kohm ±1% 0.125W 2012 (0805 INCH) | PN-903408 | 1 | ETML | FAB.0805_R 100k | 0.0200 | 1 | 0.0200 | 1
28 | R26 | RES 150kohm ±1% 0.125W 2012 (0805 INCH) | PN-241492 | 1 | ETML | FAB.0805_R 150k | 0.0200 | 1 | 0.0200 | 1
29 | R27, R30 | RES 1.0kohm ±1% 0.125W 2012 (0805 INCH) | PN-746409 | 2 | ETML | FAB.0805_R 1k0 | 0.0200 | 2 | 0.0400 | 1
30 | R28, R45 | Precision Micropower Shunt Voltage Reference, 3-pin SOT-23 |  | 2 |  |  |  | 2 | 0.0000
31 | R29 | RES 1.0Mohm ±1% 0.125W 2012 (0805 INCH) | PN-531908 | 1 | ETML | FAB.0805_R 1M | 0.0200 | 1 | 0.0200 | 1
32 | R31 | RES 180kohm ±1% 0.125W 2012 (0805 INCH) | PN-810533 | 1 | ETML | FAB.0805_R 180k | 0.0200 | 1 | 0.0200 | 1
33 | R32 | TRIMMER 250K OHM 0.5W PC PIN TOP |  | 1 |  |  |  | 1 | 0.0000
34 | R33 | RES 2.7kohm ±1% 0.125W 2012 (0805 INCH) | PN-891617 | 1 | ETML | FAB.0805_R 2k7 | 0.0200 | 1 | 0.0200 | 1
35 | R35 | BZV55C5V6 Diode Zener Single 5.6V 2% 3.33mW 2-Pin MELF DO-213AA Bag |  | 1 |  |  |  | 1 | 0.0000
36 | R37 | RES 5.6kohm ±1% 0.125W 2012 (0805 INCH) | PN-467784 | 1 | ETML | FAB.0805_R 5k6 | 0.0200 | 1 | 0.0200 | 1
37 | R38 | RES 2.2ohm ±1% 0.125W 2012 (0805 INCH) | PN-537077 | 1 | ETML | FAB.0805_R 2R2 | 0.0200 | 1 | 0.0200 | 1
38 | R39 | RES 8.2kohm ±1% 0.125W 2012 (0805 INCH) | PN-705867 | 1 | ETML | FAB.0805_R 8k2 | 0.0200 | 1 | 0.0200 | 1
39 | R40, R47 | RES 330kohm ±1% 0.125W 2012 (0805 INCH) | PN-717658 | 2 | ETML | FAB.0805_R 330k | 0.0200 | 2 | 0.0400 | 1
40 | R41, R46 | HLMP-1790 2V 2mA | MAG 355.161 | 2 | ETML | MAG 355.161 | 0.0000 | 2 | 0.0000 | 1
41 | R43 | RES 3.3kohm ±1% 0.125W 2012 (0805 INCH) | PN-560659 | 1 | ETML | FAB.0805_R 3k3 | 0.0200 | 1 | 0.0200 | 1
42 | R44 | RES 180ohm ±1% 0.125W 2012 (0805 INCH) | PN-125035 | 1 | ETML | FAB.0805_R 180R | 0.0200 | 1 | 0.0200 | 1
43 | W1 | Pâte thermoconductrice 0.7W/mK 10ml WLPF20 Fischer elektronik | WLPF20 | 1 | ETML | MAG 369.123 | 12.8300 | 1 | 12.8300 | 1
44 | X1 | Embase 4mm PCB 16A 60VDC Sn Red | PN-628499 | 1 | ETML | MAG.277.666 | 1.7000 | 1 | 1.7000 | TRUE
45 | X2 | Embase 4mm PCB 16A 60VDC Sn Black | PN-390416 | 1 | ETML | MAG.277.665 | 1.5100 | 1 | 1.5100 | TRUE
46 | X3, X6, X7 | JUMPER 2.54 1x03 | PN-771444 | 3 | ETML | MAG.283.897 | 0.0600 | 3 | 0.1800 | TRUE
47 | X4, X11, X12, X14, X15, X16, X17, X18 | TEST THT MINIATURE WT | PN-357949 | 8 | ETML | MAG.428.013 | 0.2931 | 8 | 2.3448 | TRUE
48 | X5, X13 | PIN HEADER 2.54 1x02 | PN-573903 | 2 | ETML | MAG.283.897 | 0.0400 | 2 | 0.0800 | TRUE
49 | X8, X9 | Solder bridge |  | 2 |  |  |  | 2 | 0.0000
50 | X10 | TEST THT MINIATURE BK | PN-688907 | 1 | ETML | MAG.428.011 | 0.2600 | 1 | 0.2600 | TRUE
 |  |  |  |  |  |  | Totaux | 96 | 91.36
