FormicoRofo/1438-Puit-de-courant/6-Assemblages/1438-6600-00-contrôle qualité.xlsx

Contrôle qualité
Numéro de document | Date | Auteur | Numéro de carte |  | Conclusion
1438.6600.00 | 2024-04-17 | AVR | 1438.5100.00 |  | Contrôle qualité OK
Designator | Comment | Valeur | Polatité | Brasage OK
C1 | 100nF | 1 | 2 | 2 | Légende
C2 | 100nF | 1 | 2 | 2 | Problème | 0
C3 | 100nF | 1 | 2 | 2 | Invérifiable | 1
C4 | 100nF | 1 | 2 | 2 | En ordre | 2
C5 | 1uF | 1 | 2 | 2
C6 | 10nF | 1 | 2 | 2
C7 | 220uF 16V | 2 | 2 | 2
C8 | 1uF | 1 | 2 | 2
C9 | 100nF | 1 | 2 | 2
C10 | 1uF | 1 | 2 | 2
C11 | 100nF | 1 | 2 | 2
C12 | 1uF | 1 | 2 | 2
C13 | 1uF | 1 | 2 | 2
C14 | 1uF | 1 | 2 | 2
C15 | 1uF | 1 | 2 | 2
E1 | 678-39-C | 2 | 2 | 2
E2 | 678-39-C | 2 | 2 | 2
F1 | 2A | 2 | 2 | 2
F2 | IRLR7843 | 2 | 2 | 2
K1 | BD912 | 2 | 2 | 2
K2 | LM317T | 2 | 2 | 2
K3 | IRLR7843 | 2 | 2 | 2
K4 | TLC555CDR | 2 | 2 | 2
K5 | BC847C | 2 | 2 | 2
K6 | BC847C | 2 | 2 | 2
K7 | BC847C | 2 | 2 | 2
K8 | BC847C | 2 | 2 | 2
K9 | LM2662M | 2 | 2 | 2
K10 | BC857CLT1G | 2 | 2 | 2
P2 | Sticker | 2 | 2 | 2
R1 | 150R | 2 | 2 | 2
R2 | 200R | 2 | 2 | 2
R3 | 3R3 1W | 2 | 2 | 2
R4 | 3R3 1W | 2 | 2 | 2
R5 | 22k | 2 | 2 | 2
R6 | 220R | 2 | 2 | 2
R7 | 2R2 1W | 2 | 2 | 2
R8 | 2R2 1W | 2 | 2 | 2
R9 | 2R2 1W | 2 | 2 | 2
R10 | 2R2 1W | 2 | 2 | 2
R11 | 10k | 2 | 2 | 2
R12 | 10k | 2 | 2 | 2
R13 | 22k | 2 | 2 | 2
R14 | 200R | 2 | 2 | 2
R16 | 1K8 | 2 | 2 | 2
R17 | 47k | 2 | 2 | 2
R18 | 220R | 2 | 2 | 2
R19 | 220k | 2 | 2 | 2
R20 | LL4448-GS08 | 2 | 2 | 2
R21 | 10k | 2 | 2 | 2
R22 | 220k | 2 | 2 | 2
R23 | 47k | 2 | 2 | 2
R24 | 150k | 2 | 2 | 2
R25 | LL4448-GS08 | 2 | 2 | 2
R26 | 150k | 2 | 2 | 2
R27 | 1k0 | 2 | 2 | 2
R28 | LM4041-ADJ | 2 | 2 | 2
R29 | 1M | 2 | 2 | 2
R30 | 1k0 | 2 | 2 | 2
R31 | 180k | 2 | 2 | 2
R32 | 250K | 2 | 2 | 2
R33 | 2k7 | 2 | 2 | 2
R34 | 22k | 2 | 2 | 2
R35 | BZV55C5V6 | 2 | 2 | 2
R36 | 10k | 2 | 2 | 2
R37 | 5k6 | 2 | 2 | 2
R38 | 2R2 | 2 | 2 | 2
R39 | 8k2 | 2 | 2 | 2
R40 | 330k | 2 | 2 | 2
R41 | HLMP-1790 | 2 | 2 | 2
R42 | LL4448-GS08 | 2 | 2 | 2
R43 | 3k3 | 2 | 2 | 2
R44 | 180R | 2 | 2 | 2
R45 | LM4041-ADJ | 2 | 2 | 2
R46 | HLMP-1790 | 2 | 2 | 2
R47 | 330k | 2 | 2 | 2
W1 | WLPF20 | 2 | 2 | 2
X1 | 4mm/RD | 2 | 2 | 2
X2 | 4mm/BK | 2 | 2 | 2
X3 | 2.54 | 2 | 2 | 2
X4 | 5002 | 2 | 2 | 2
X5 | 2.54 | 2 | 2 | 2
X6 | 2.54 | 2 | 2 | 2
X7 | 2.54 | 2 | 2 | 2
X8 | Solder bridge | 2 | 2 | 2
X9 | Solder bridge | 2 | 2 | 2
X10 | 5001 | 2 | 2 | 2
X11 | 5002 | 2 | 2 | 2
X12 | 5002 | 2 | 2 | 2
X13 | 2.54 | 2 | 2 | 2
X14 | 5002 | 2 | 2 | 2
X15 | 5002 | 2 | 2 | 2
X16 | 5002 | 2 | 2 | 2
X17 | 5002 | 2 | 2 | 2
X18 | 5002 | 2 | 2 | 2
