FormicoRofo/1438-Puit-de-courant/5-Hardware/1438-5100-00-Puit de courant/1438-5100-00-Puit de courant_PCB.PDF

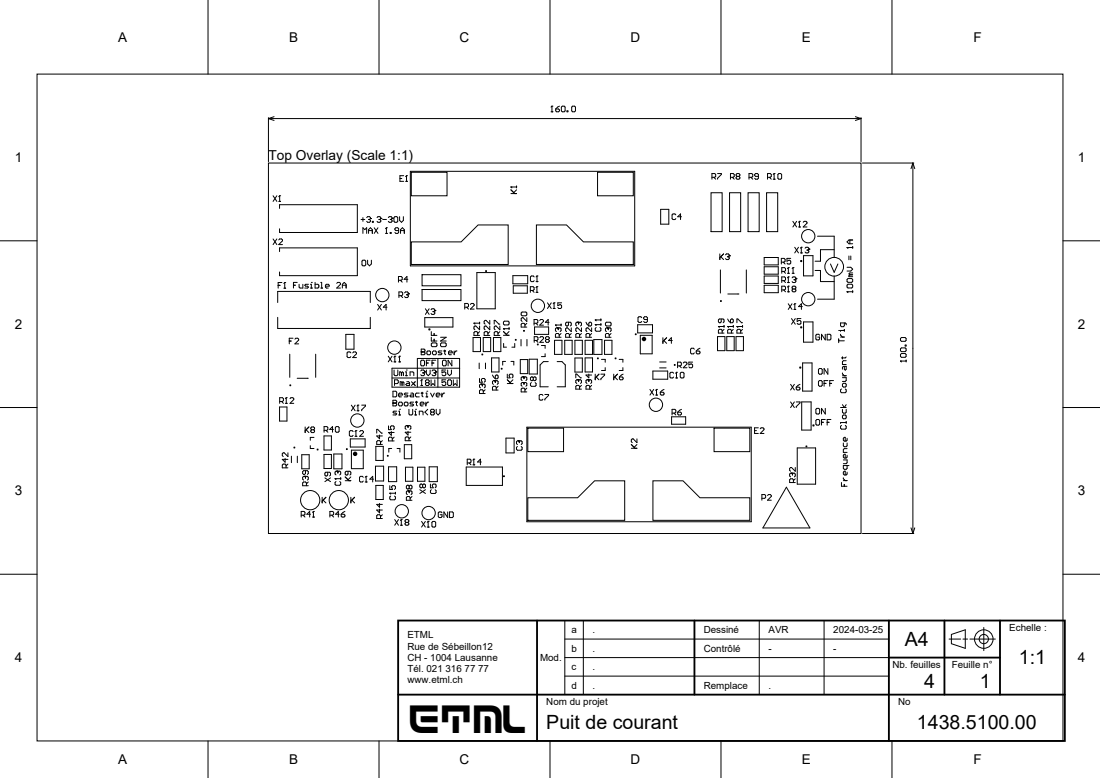
[picture p9: page 1]

ETML Rue de Sébeillon12 CH - 1004 Lausanne Tél. 021 316 77 77 www.etml.ch | Mod. | a | . | Dessiné | AVR | 2024-03-25 | A4 | | Echelle : 1:1

b | . | Contrôlé | - | -
c | . | | | | Nb. feuilles 4 | Feuille n° 1
d | . | Remplace | .

ETML | Nom du projet Puit de courant | | | | | | No 1438.5100.00

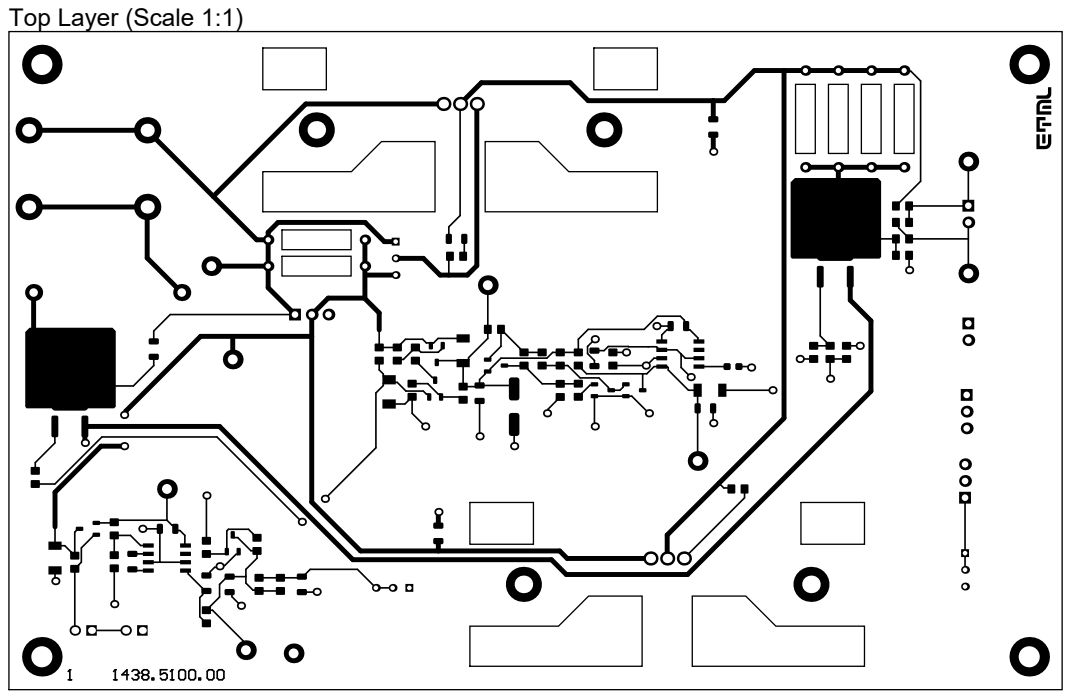
[picture p10: page 2]
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

b | . | Contrôlé | - | -
c | . | | | | Nb. feuilles 4 | Feuille n° 2
d | . | Remplace | .

ETML | Nom du projet | | | | | | No

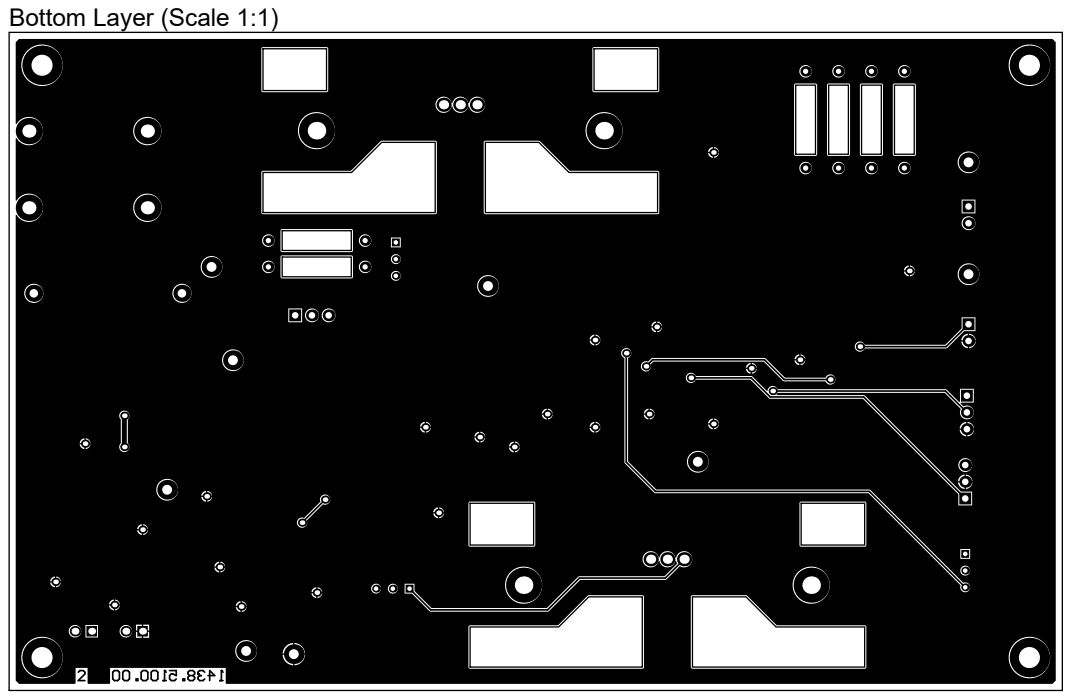
[picture p11: page 3]
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

b | . | Contrôlé | - | -
c | . | | | | Nb. feuilles 4 | Feuille n° 3
d | . | Remplace | .

ETML | Nom du projet | | | | | | No

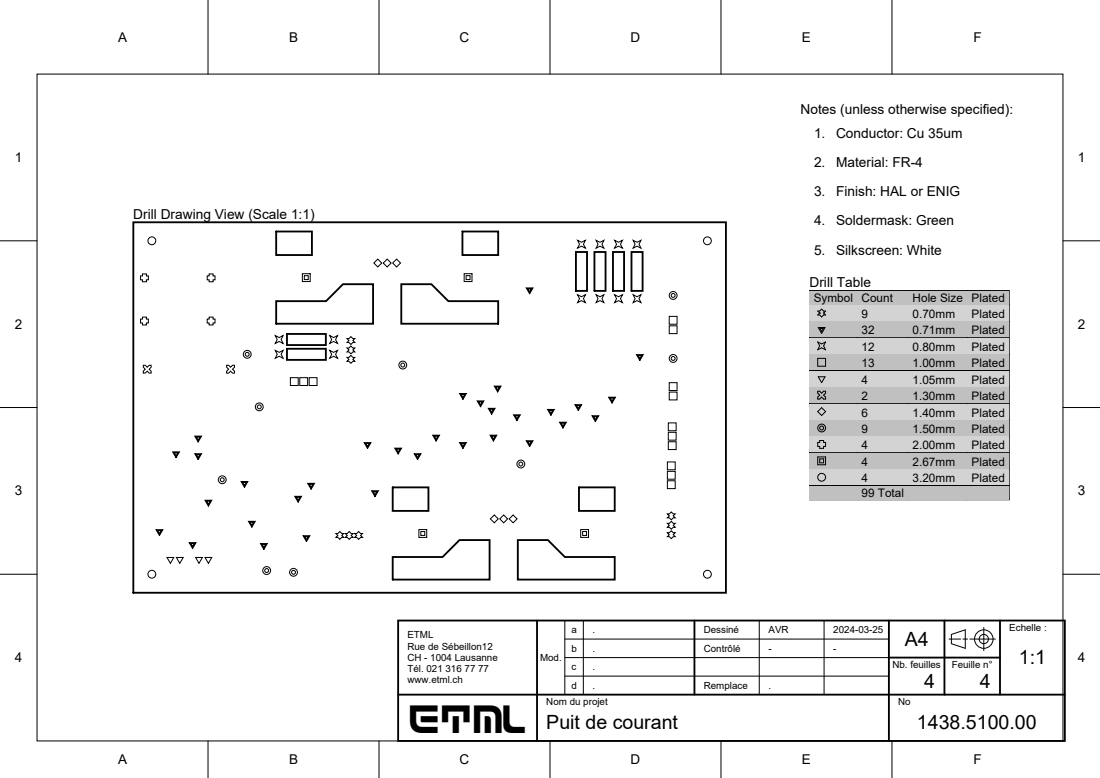
[picture p12: page 4]

Notes (unless otherwise specified):
1. Conductor: Cu 35um

3. Finish: HAL or ENIG

Drill Drawing View (Scale 1:1)

Symbol | Count | Hole Size | Plated

9 | 0.70mm | Plated
32 | 0.71mm | Plated
12 | 0.80mm | Plated
13 | 1.00mm | Plated
4 | 1.05mm | Plated
2 | 1.30mm | Plated
6 | 1.40mm | Plated
9 | 1.50mm | Plated
4 | 2.00mm | Plated
4 | 2.67mm | Plated
4 | 3.20mm | Plated
99 Total

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

b | . | Contrôlé | - | -
c | . | | | | Nb. feuilles 4 | Feuille n° 4
d | . | Remplace | .

ETML | Nom du projet | | | | | | No
