FormicoRofo/1438-Puit-de-courant/5-Hardware/1438-5100-00-Puit de courant/1438-5200-00-Puit de courant_SCH.PDF

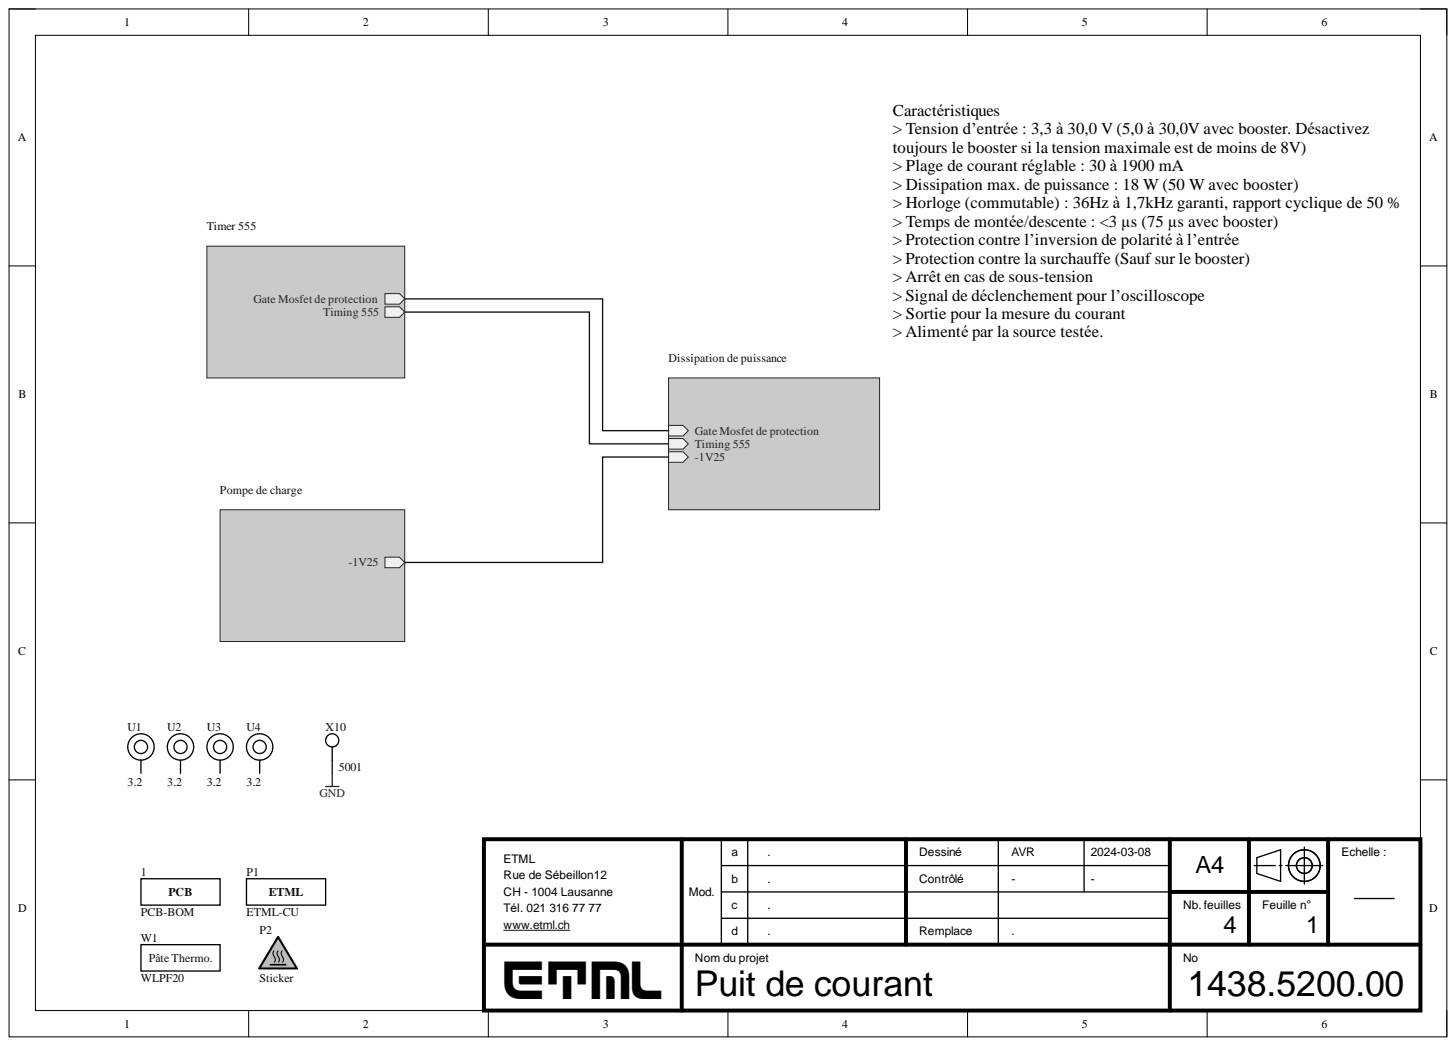
[picture p13: page 1]

Caractéristiques
> Tension d’entrée : 3,3 à 30,0 V (5,0 à 30,0V avec booster. Désactivez
toujours le booster si la tension maximale est de moins de 8V)
> Plage de courant réglable : 30 à 1900 mA
> Dissipation max. de puissance : 18 W (50 W avec booster)
> Horloge (commutable) : 36Hz à 1,7kHz garanti, rapport cyclique de 50 %
> Temps de montée/descente : <3 µs (75 µs avec booster)
> Protection contre l’inversion de polarité à l’entrée
> Protection contre la surchauffe (Sauf sur le booster)
> Arrêt en cas de sous-tension
> Signal de déclenchement pour l’oscilloscope
> Sortie pour la mesure du courant
> Alimenté par la source testée.

Gate Mosfet de protection

ETML Rue de Sébeillon12 CH - 1004 Lausanne Tél. 021 316 77 77 www.etml.ch | Mod. | a | . | Dessiné | AVR | 2024-03-08 | A4 | | Echelle :

b | . | Contrôlé | - | -

c | . | | | | Nb. feuilles 4 | Feuille n° 1

d | . | Remplace | .

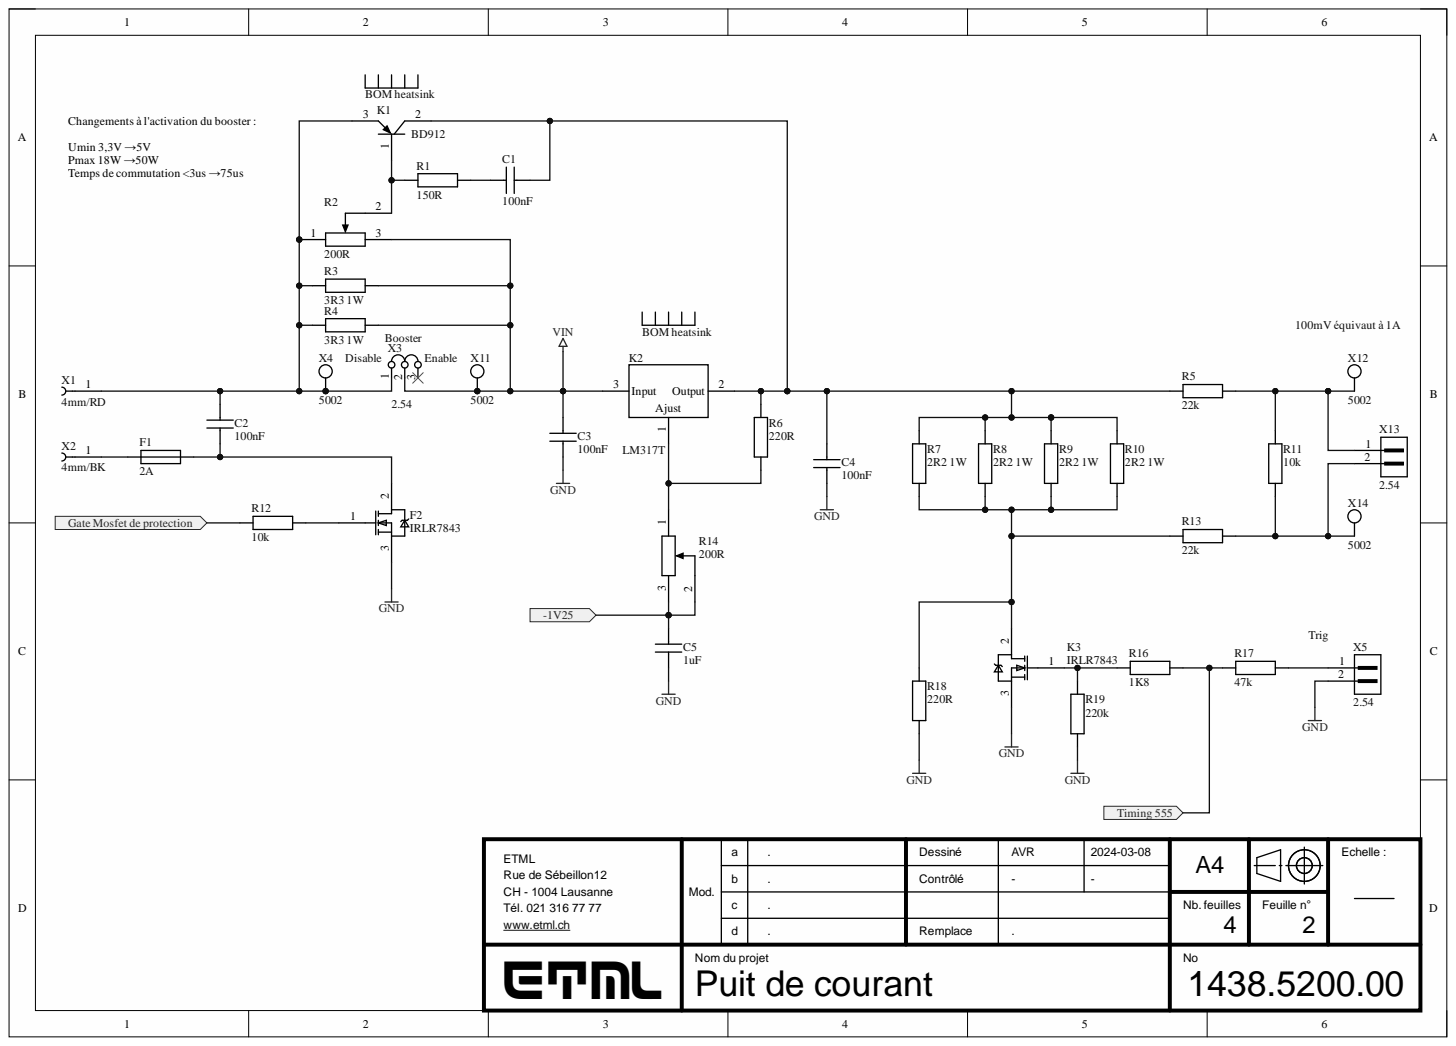
[picture p14: page 2]

Changements à l'activation du booster :

Gate Mosfet de protection

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

b | . | Contrôlé | - | -

c | . | | | | Nb. feuilles 4 | Feuille n° 2

d | . | Remplace | .

ETML | Nom du projet Puit de courant | | | | | | No 1438.5200.00

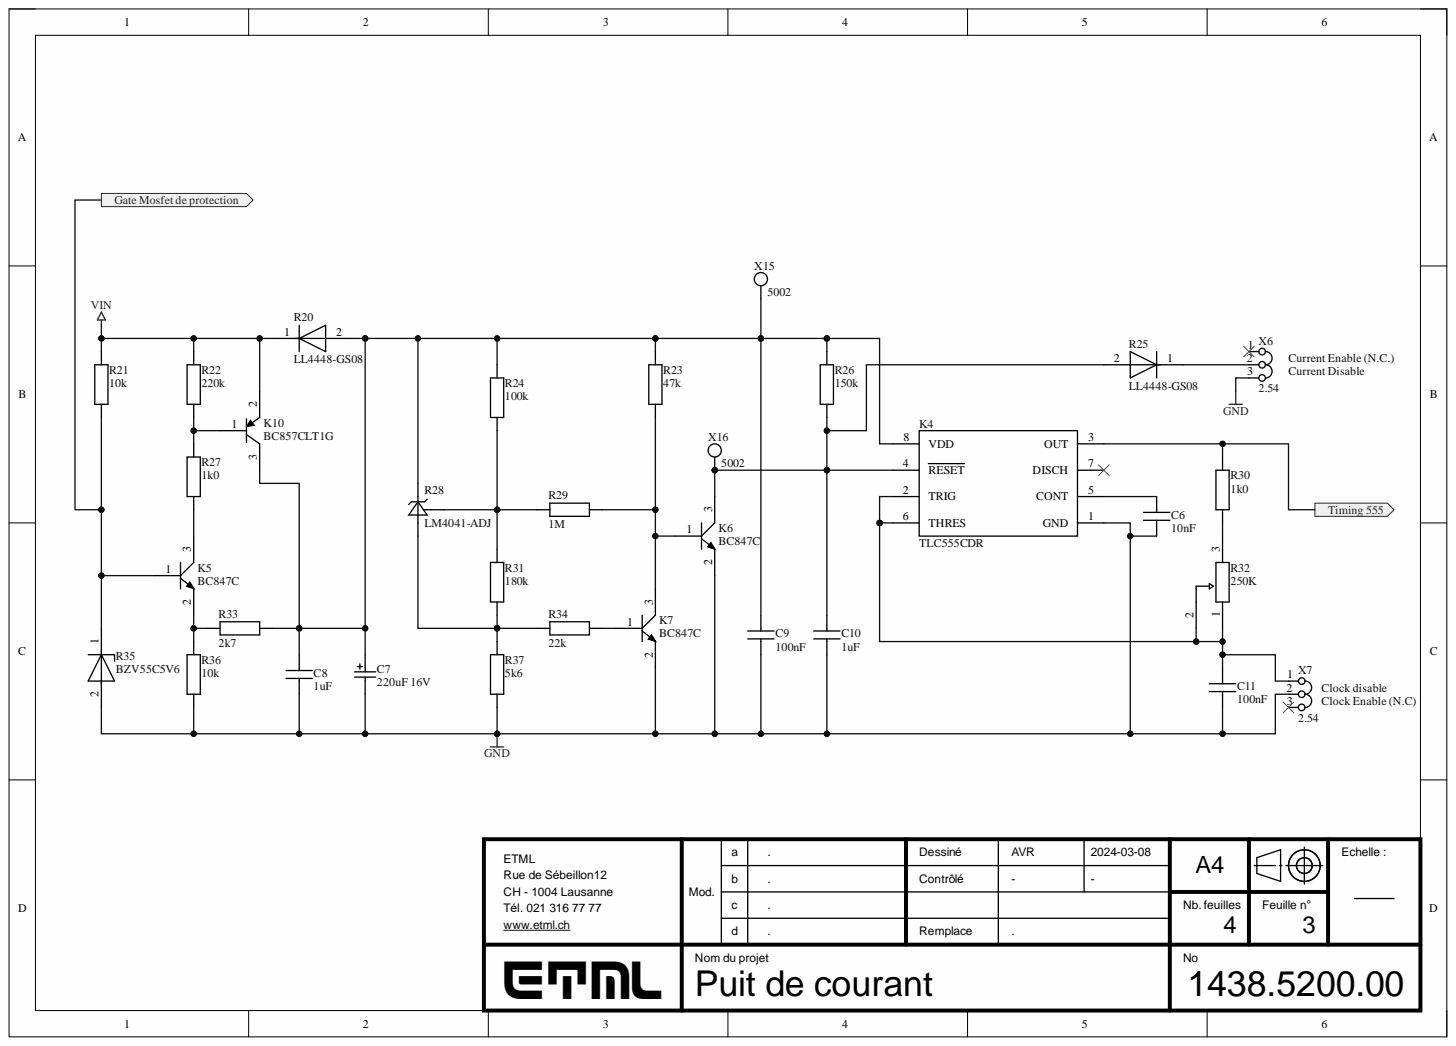
[picture p15: page 3]

8 | K4 TLC5 V D D O U T RESE T DISC H TRIG CO N T T HRE S G N D

ET M L ETML Rue de Sébeillon12 CH - 1004 Lausanne Tél. 021 316 77 77 w w w .et m l . c h | Mod . | | | Des s i n é | AV R | 2024-03-0 8 | A4 | | Echelle :

abcd | .... | Cont r ô l é | | -

-. | | Nb. feuilles 4 | Feuille n ° 3

Rempla c e

Nom du projet Puit de courant | | | | | | N o 1438.5200.0 0

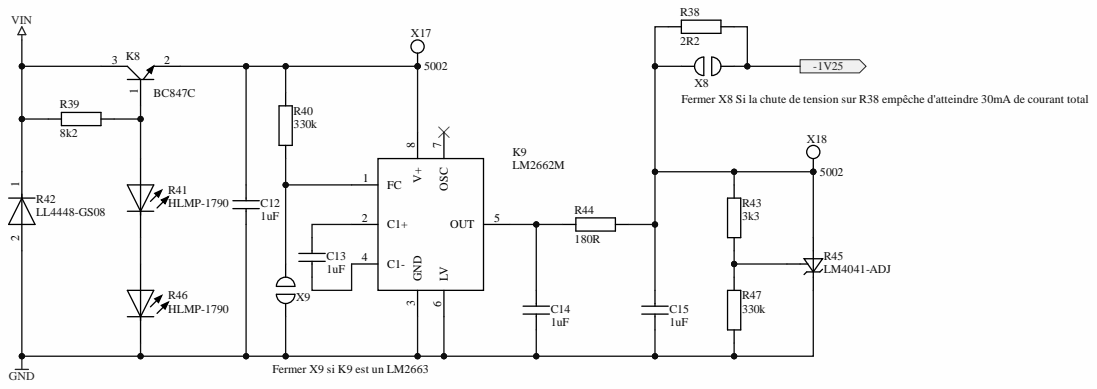
[picture p16: page 4]
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

abcd | .... | Cont r ô l é | | -

-. | | Nb. feuilles 4 | Feuille n ° 4

Rempla c e

Nom du projet Puit de courant | | | | | | N o 1438.5200.0 0
