FormicoRofo/1438-Puit-de-courant/5-Hardware/1438-5100-00-Puit de courant/1438-5000-00-Puit de courant_ASY.PDF

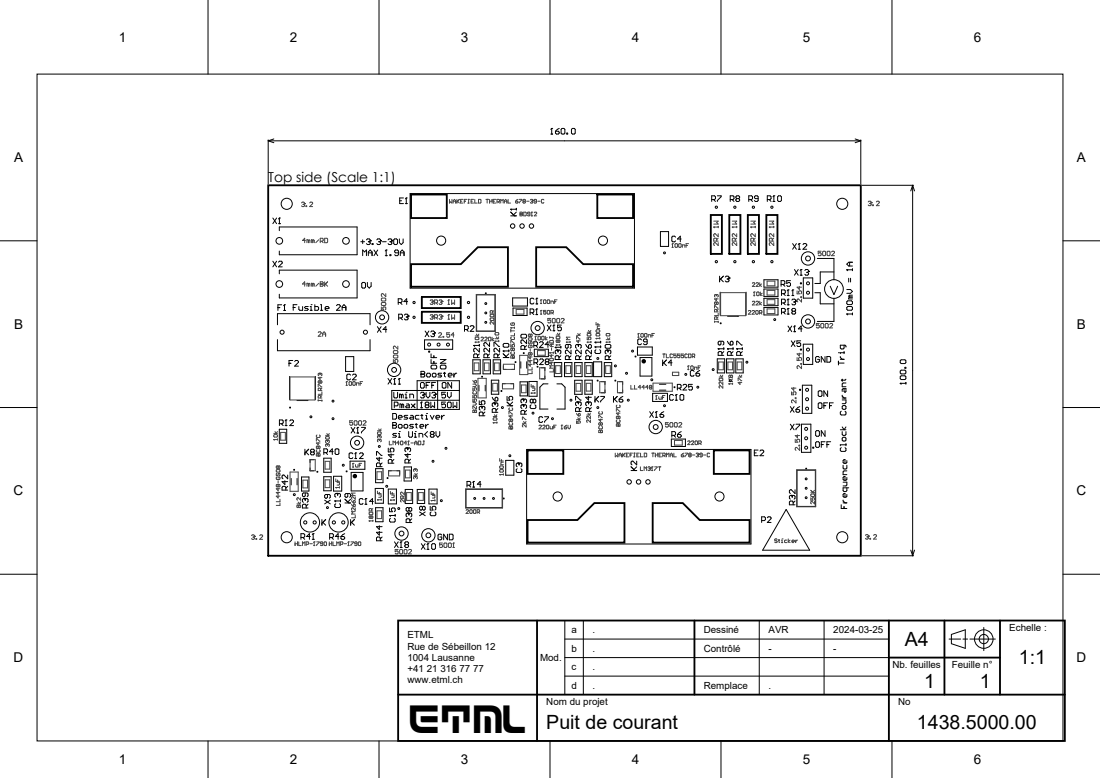
[picture p17: page 1]
