FormicoRofo/1438-Puit-de-courant/3-Documents/1438-3600-00-Planification.pdf

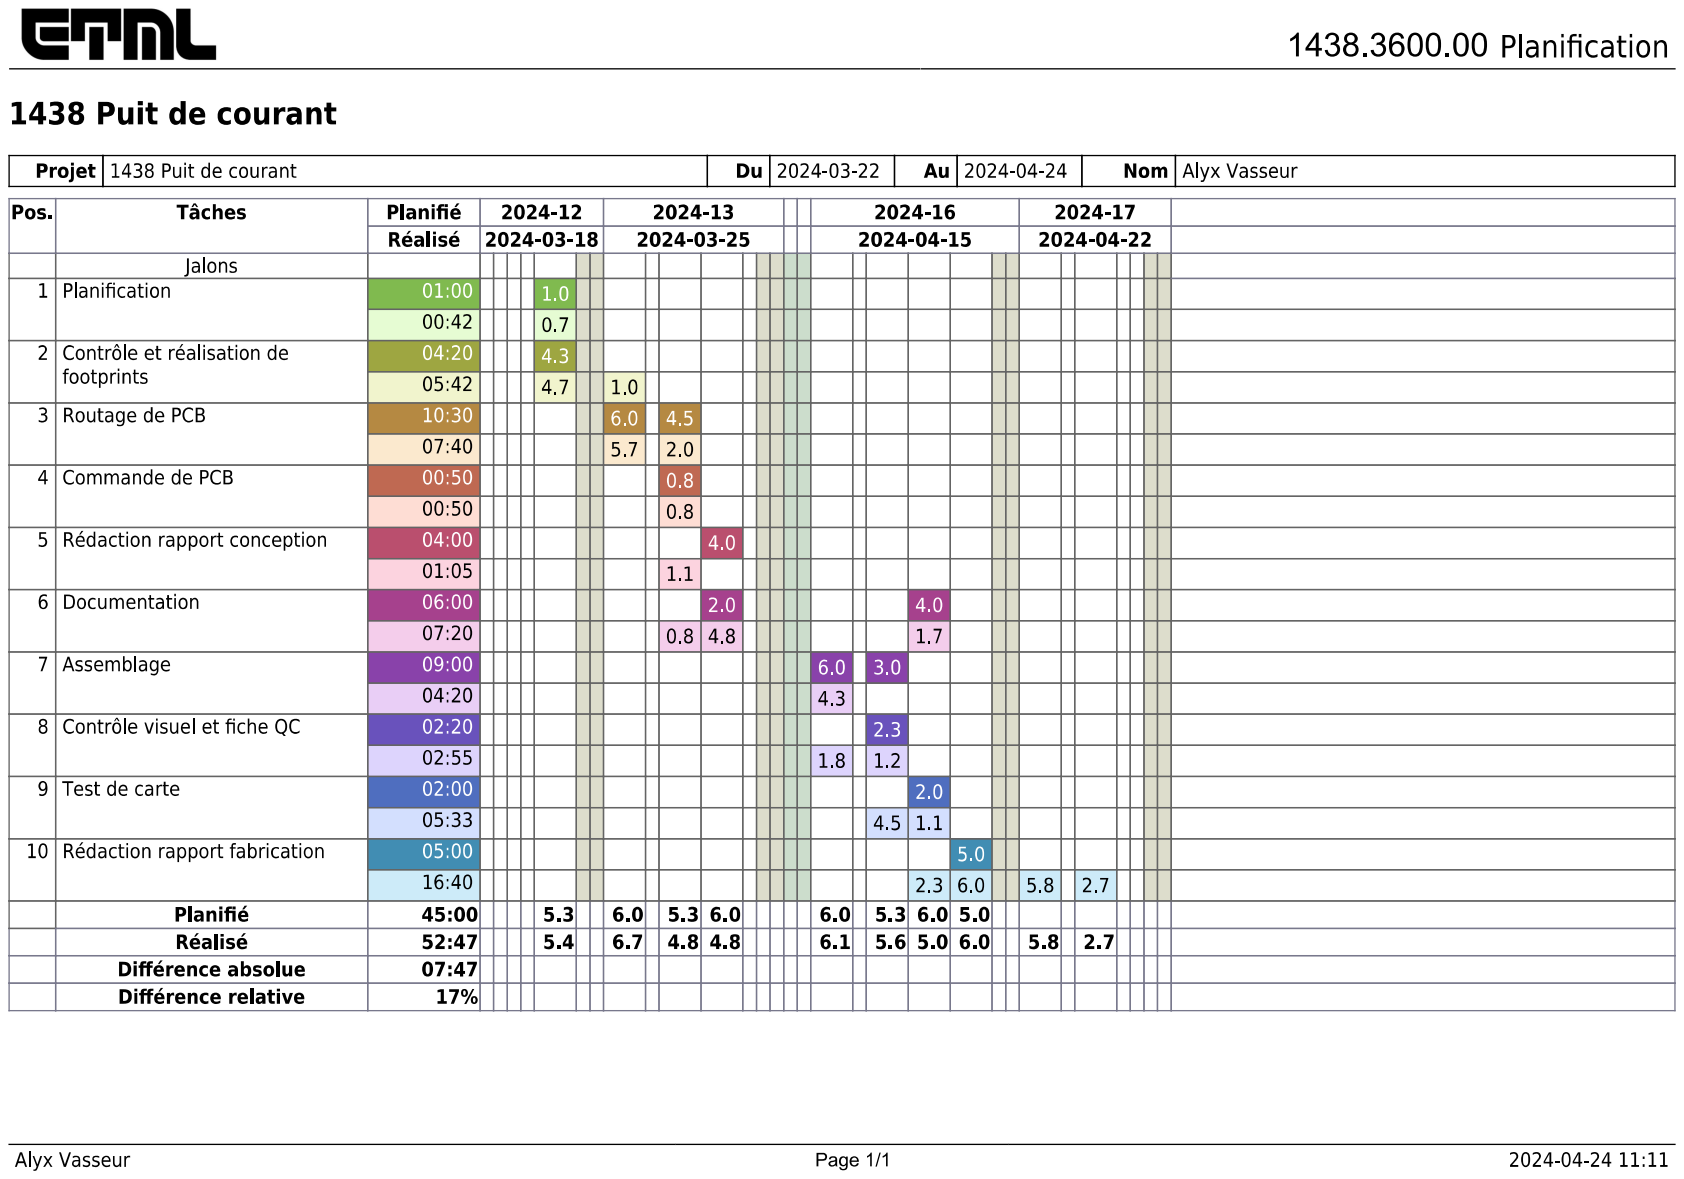
[picture p18: page 1]
