FormicoRofo/1438-Puit-de-courant/(list of files, drawings)

Other design files:
5-Hardware/1438-5100-00-Puit de courant/1438-5100-00-Puit de courant.PrjPcb
5-Hardware/1438-5100-00-Puit de courant/Dissipation de puissance.SchDoc
5-Hardware/1438-5100-00-Puit de courant/ETML_A4_2L.PcbDoc
5-Hardware/1438-5100-00-Puit de courant/Pompe de charge.SchDoc
5-Hardware/1438-5100-00-Puit de courant/Schéma bloc.SchDoc
5-Hardware/1438-5100-00-Puit de courant/Timer 555.SchDoc
