FormicoRofo/1438-Puit-de-courant/(commit log)

2024-02-23 Synchro base de donnée projets
    Ajout des doccuments générés par la base de projets. 1438.3300.00 sera probablement supprimé prochainement.
2024-02-23 modification rapport
    Ajout cahier des charges et planification
2024-02-26 Projet altium initial
    Ajout du projet et configuration des noms et numéro de document
    [1438-5100-Puit de courant.PrjPcb, ETML_A4_2L.PcbDoc, Sheet1.SchDoc]
2024-02-26 Ajout de plusieurs symboles et progrès sur le schéma.
    [1438-5100-Puit de courant.PrjPcb, ETML_A4_2L.PcbDoc, Sheet1.SchDoc]
2024-02-29 Repaired Symbols
    [1438-5100-Puit de courant.PrjPcb]
2024-02-29 ajout schéma bloc
    [1438-5100-Puit de courant.PrjPcb, Sheet1.SchDoc, Sheet2.SchDoc]
2024-02-29 Renommé schéma principal
    [1438-5100-Puit de courant.PrjPcb, Dissipation de puissance.SchDoc, Schéma bloc.SchDoc, Sheet1.SchDoc]
2024-02-29 Update schéma
    [Dissipation de puissance.SchDoc, Schéma bloc.SchDoc, Timer 555.SchDoc]
2024-02-29 Ajouté des composants manquants.
    [1438-5100-Puit de courant.PrjPcb, Dissipation de puissance.SchDoc, Pompe de charge.SchDoc, Schéma bloc.SchDoc, Timer 555.SchDoc]
2024-02-29 Ajouté plusieurs composants Reste potentiomètre du 555 à dimentionner
    [1438-5100-Puit de courant.PrjPcb, Dissipation de puissance.SchDoc, Pompe de charge.SchDoc, Timer 555.SchDoc, WAKEFIELD THERMAL 678-39-C element for BOM.SchLib]
2024-03-01 Fini dimentionnement pot 555
    [1438-5100-Puit de courant.PrjPcb, Dissipation de puissance.SchDoc, Timer 555.SchDoc]
2024-03-01 Tout les composants sont sur le schéma
    [1438-5100-Puit de courant.PrjPcb, Dissipation de puissance.SchDoc, Pompe de charge.SchDoc, Schéma bloc.SchDoc, Timer 555.SchDoc]
2024-03-01 Changé quelques représentations schématiques de composants
    [Dissipation de puissance.SchDoc, Pompe de charge.SchDoc, Schéma bloc.SchDoc, Timer 555.SchDoc]
2024-03-01 Mis à jour des représentations schématiques
    [1438-5100-Puit de courant.PrjPcb, Dissipation de puissance.SchDoc, Pompe de charge.SchDoc, Timer 555.SchDoc]
2024-03-01 Changement de symboles
    [1438-5100-Puit de courant.PrjPcb, Pompe de charge.SchDoc]
2024-03-04 Nommé composants
    [1438-5100-Puit de courant.PrjPcb, Dissipation de puissance.SchDoc, Pompe de charge.SchDoc, Schéma bloc.SchDoc, Timer 555.SchDoc]
2024-03-04 Modifié properties bom
    [1438-5100-Puit de courant_BOM.xlsx, Dissipation de puissance.SchDoc, Pompe de charge.SchDoc, Timer 555.SchDoc]
2024-03-04 Complété BOM
    [1438-5100-Puit de courant_BOM.xlsx, Dissipation de puissance.SchDoc, Pompe de charge.SchDoc, Timer 555.SchDoc]
2024-03-04 Fin de journée
2024-03-06 Schéma altium PréTPI terminé
    [1438-5100-Puit de courant_BOM.xlsx, Dissipation de puissance.SchDoc, Pompe de charge.SchDoc, Timer 555.SchDoc]
2024-03-07 Edité led verte
    [1438-5100-Puit de courant.PrjPcb, Pompe de charge.SchDoc, Timer 555.SchDoc]
2024-03-07 Renommé HLMP-1790
    [1438-5100-Puit de courant.PrjPcb]
2024-03-07 Ajouté des test pints POSER QUESTION POSITION DE VIN
    [1438-5100-Puit de courant.PrjPcb, Dissipation de puissance.SchDoc, Pompe de charge.SchDoc, Schéma bloc.SchDoc, Timer 555.SchDoc]
2024-03-08 Schéma FINI et BOM complète (je crois)
    [1438-5100-Puit de courant.PrjPcb, 1438-5100-Puit de courant_BOM.xlsx, 1438-5600-Puit de courant_BOM.xlsx, Dissipation de puissance.SchDoc, Pompe de charge.SchDoc, Schéma bloc.SchDoc, Timer 555.SchDoc]
2024-03-11 Pre-TPI (presque) terminé
    [1438-5100-Puit de courant.PrjPcb, Schéma bloc.SchDoc]
2024-03-11 PreTPI terminé
    [1438-5600-Puit de courant_BOM.xlsx, Schéma bloc.SchDoc]
2024-03-11 Ajouté différence fusible/porte fusible
    [1438-5600-Puit de courant_BOM.xlsx, Dissipation de puissance.SchDoc]
2024-03-11 Réception des produits Mouser
    [1438-5600-Puit de courant_BOM.xlsx]
2024-03-11 Réception des produits Farnell
    [1438-5600-Puit de courant_BOM.xlsx]
2024-03-22 Rasemblé symboles dans une librairie, début footprint TO220+cooler
    [1438-5100-Puit de courant.PrjPcb, 1438-5600-Puit de courant_BOM.xlsx, Dissipation de puissance.SchDoc, ETML_A4_2L.PcbDoc, Pompe de charge.SchDoc, TO220 With wakefield thermal.PcbLib, Timer 555.SchDoc]
2024-03-22 Composants personalisés footprint OK
    [1438-5100-Puit de courant.PrjPcb, Dissipation de puissance.SchDoc, TO220 With wakefield thermal.PcbLib]
2024-03-25 Routage presque terminé
    [1438-5100-Puit de courant.PrjPcb, Dissipation de puissance.SchDoc, ETML_A4_2L.PcbDoc, Pompe de charge.SchDoc, Schéma bloc.SchDoc, TO220 With wakefield thermal.PcbLib, Timer 555.SchDoc]
2024-03-27 Fini le routage du PCB
    [1438-5100-Puit de courant.PrjPcb, 1438-5600-Puit de courant_BOM.xlsx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]
2024-03-27 Reposition et sauvegarde avant rename du projet
    [1438-5100-Puit de courant.PrjPcb, 1438-5600-00-Puit de courant_BOM.xlsx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]
2024-03-27 Rename du projet PCB
    [1438-5100-00-Puit de courant.PrjPcb, 1438-5600-00-Puit de courant_BOM.xlsx, Dissipation de puissance.SchDoc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]
2024-03-27 Docu à jour, PCB terminé, prêt à la synchronisation
    [ETML_A4_2L.~(2).PcbDoc, ETML_A4_2L.~(5).PcbDoc]
2024-03-28 Avancé rapport
    [Dissipation de puissance.SchDoc, Schéma bloc.SchDoc]
2024-04-19 Récupéré les librairies
    [Dissipation de puissance.SchDoc, Schéma bloc.SchDoc]
2024-04-19 Ajouté le prix et numéro du PCB dans la BOM
    [1438-5100-00-Puit de courant_BOM.xlsx, Schéma bloc.SchDoc]
2024-04-19 Continué rapport
    [1438-5100-00-Puit de courant_BOM.xlsx, 1438-5600-00-Puit de courant_BOM.xlsx, 1438-6600-00-contrôle qualité.xlsx]
2024-04-24 Fin TPI !
    [1438-5600-00-Puit de courant_BOM.xlsx, ETML_A4_2L.PcbDoc, Timer 555.SchDoc]
2024-04-24 Sauvegarde des rapports
2024-04-24 Ajout numéro journal de travail
